denshiruko/cansat2026-board/cansat2026/cansat2026.kicad_pcb

## KiCad design cansat2026/cansat2026.kicad_pcb (2026-10-26)

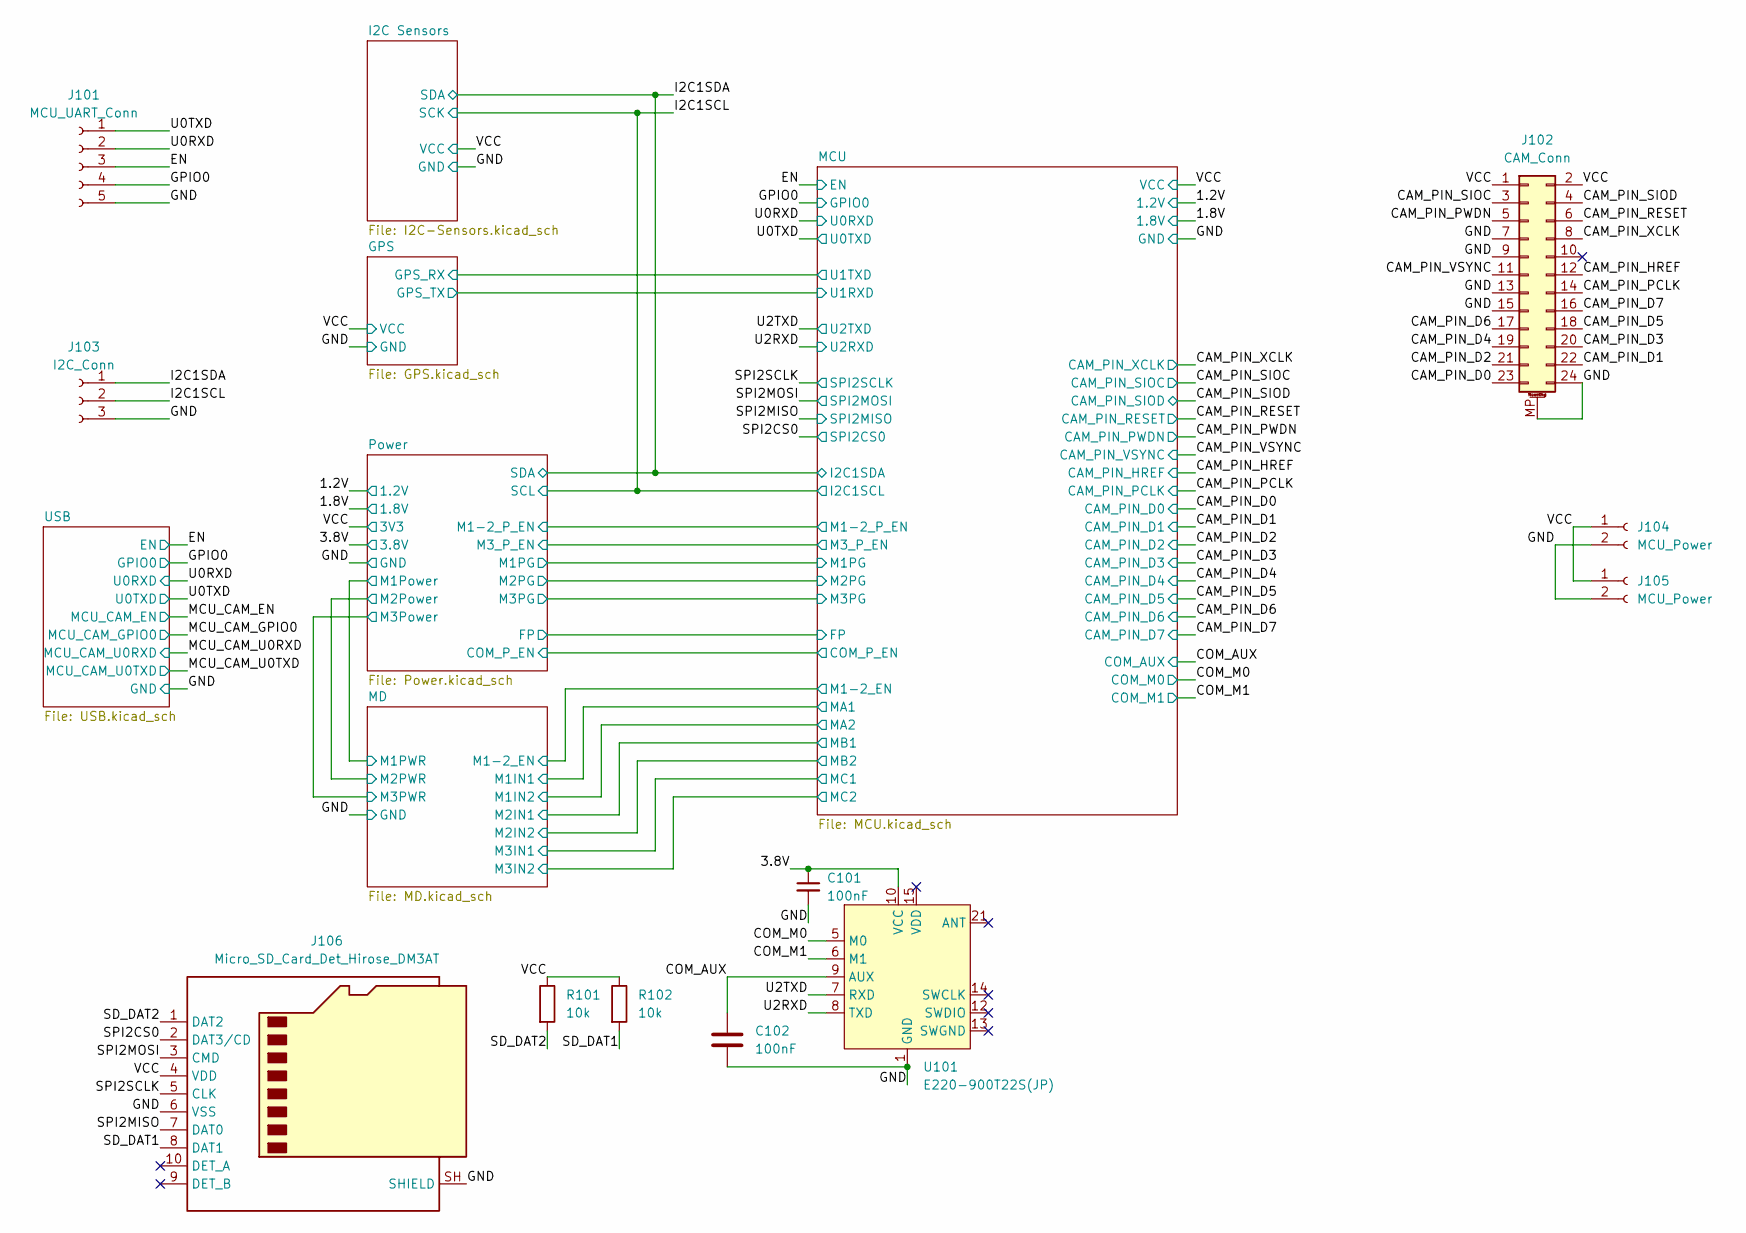
[picture p1: schematic cansat2026.kicad_sch]

Parts:
C101, C102: 100nF; C_0402_1005Metric; LCSC Part C1525
J101: MCU_UART_Conn; PinSocket_1x05_P2.54mm_Vertical
J102: CAM_Conn; SHOUHAN_XJH2.0_0.43-24P_1x24-1MP_P0.50mm_Horizontal; LCSC Part C5373439
J103: I2C_Conn; JST_XH_B3B-XH-A_1x03_P2.50mm_Vertical
J104, J105: MCU_Power; JST_XH_B2B-XH-A_1x02_P2.50mm_Vertical
J106: Micro_SD_Card_Det_Hirose_DM3AT; microSD_HC_Hirose_DM3AT-SF-PEJM5
R101, R102: 10k; R_0402_1005Metric; LCSC Part C25744
U101: E220-900T22S(JP)

Connections:
/3.8V: C101.1, U101.10 (VCC); also elsewhere on the board
/CAM_PIN_D0: J102.23; also elsewhere on the board
/CAM_PIN_D1: J102.22; also elsewhere on the board
/CAM_PIN_D2: J102.21; also elsewhere on the board
/CAM_PIN_D3: J102.20; also elsewhere on the board
/CAM_PIN_D4: J102.19; also elsewhere on the board
/CAM_PIN_D5: J102.18; also elsewhere on the board
/CAM_PIN_D6: J102.17; also elsewhere on the board
/CAM_PIN_D7: J102.16; also elsewhere on the board
/CAM_PIN_HREF: J102.12; also elsewhere on the board
/CAM_PIN_PCLK: J102.14; also elsewhere on the board
/CAM_PIN_PWDN: J102.5; also elsewhere on the board
/CAM_PIN_RESET: J102.6; also elsewhere on the board
/CAM_PIN_SIOC: J102.3; also elsewhere on the board
/CAM_PIN_SIOD: J102.4; also elsewhere on the board
/CAM_PIN_VSYNC: J102.11; also elsewhere on the board
/CAM_PIN_XCLK: J102.8; also elsewhere on the board
/COM_AUX: C102.1, U101.9 (AUX); also elsewhere on the board
/COM_M0: U101.5 (M0); also elsewhere on the board
/COM_M1: U101.6 (M1); also elsewhere on the board
/EN: J101.3; also elsewhere on the board
/GPIO0: J101.4; also elsewhere on the board
/I2C1SCL: J103.2; also elsewhere on the board
/I2C1SDA: J103.1; also elsewhere on the board
/SD_DAT1: J106.8 (DAT1), R102.2
/SD_DAT2: J106.1 (DAT2), R101.2
/SPI2CS0: J106.2 (DAT3/CD); also elsewhere on the board
/SPI2MISO: J106.7 (DAT0); also elsewhere on the board
/SPI2MOSI: J106.3 (CMD); also elsewhere on the board
/SPI2SCLK: J106.5 (CLK); also elsewhere on the board
/U0RXD: J101.2; also elsewhere on the board
/U0TXD: J101.1; also elsewhere on the board
/U2RXD: U101.8 (TXD); also elsewhere on the board
/U2TXD: U101.7 (RXD); also elsewhere on the board
/VCC: J102.1, J102.2, J104.1, J105.1, J106.4 (VDD), R101.1, R102.1; also elsewhere on the board
GND: C101.2, C102.2, J101.5, J102.7, J102.9, J102.13, J102.15, J102.24, J102.MP (MountPin), J103.3, J104.2, J105.2, J106.6 (VSS), J106.SH (SHIELD), U101.1 (GND), U101.2 (GND), U101.3 (GND), U101.4 (GND), U101.11 (GND), U101.19 (GND), U101.20 (GND), U101.22 (GND); also elsewhere on the board

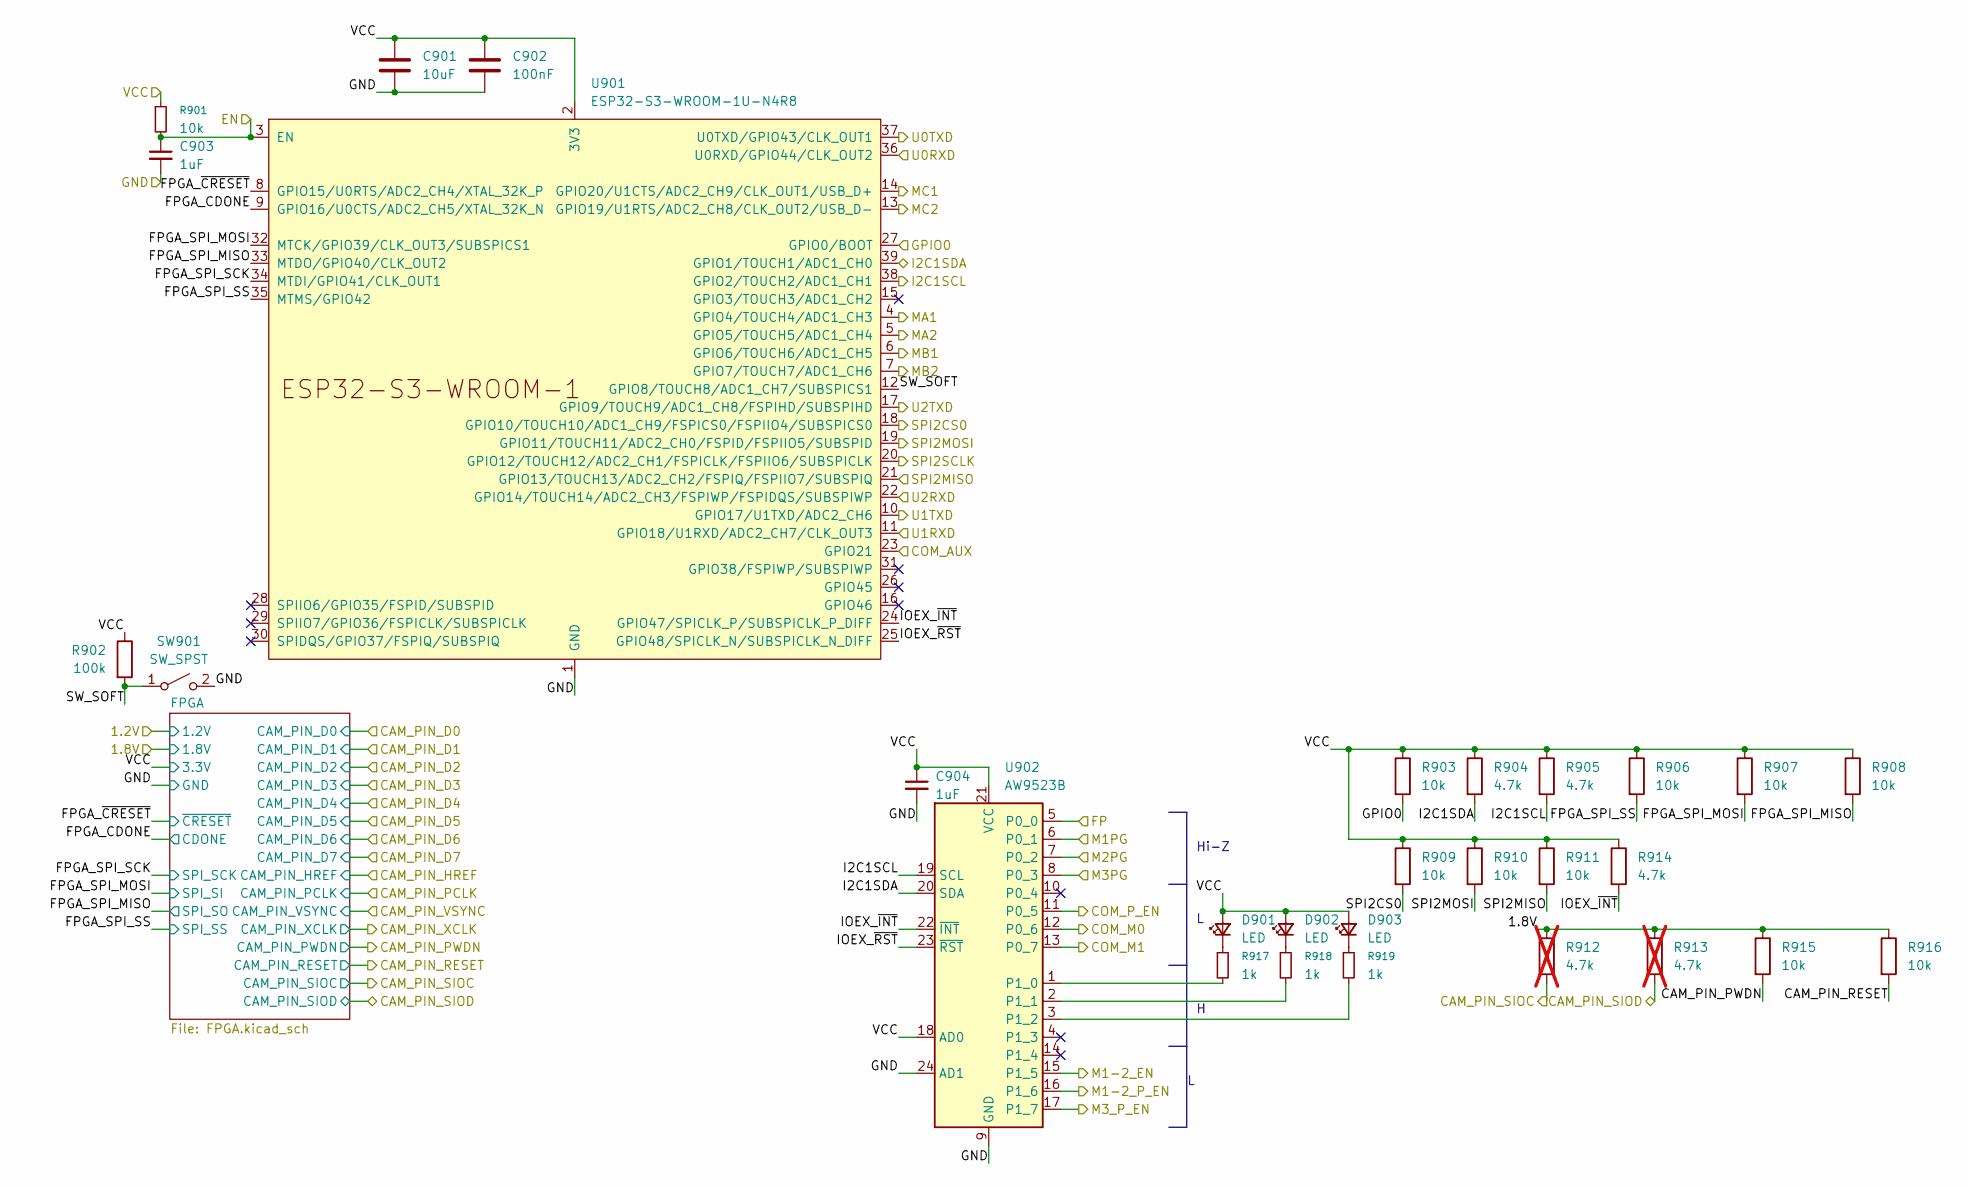
[picture p2: schematic MCU.kicad_sch]

Parts:
C901: 10uF; C_0402_1005Metric; LCSC Part C15525
C902: 100nF; C_0402_1005Metric; LCSC Part C1525
C903, C904: 1uF; C_0402_1005Metric; LCSC Part C52923
D901, D902, D903: LED; LED_0603_1608Metric
R901, R903, R906, R907, R908, R909, R910, R911, R915, R916: 10k; R_0402_1005Metric; LCSC Part C25744
R902: 100k; R_0402_1005Metric; LCSC Part C25741
R904, R905, R914: 4.7k; R_0402_1005Metric; LCSC Part C25900
R912, R913: 4.7k; R_0402_1005Metric; LCSC Part C25900; not fitted
R917, R918, R919: 1k; R_0402_1005Metric; LCSC Part C11702
SW901: SW_SPST; IS-1235-G
U901: ESP32-S3-WROOM-1U-N4R8; ESP32-S3-WROOM-1U; Mouser Part 356-ESP32S3WRM1UN4R8
U902: AW9523B; QFN-24-1EP_4x4mm_P0.5mm_EP2.7x2.7mm; LCSC Part C148077

Connections:
/1.8V: R912.1, R913.1, R915.1, R916.1; also elsewhere on the board
/CAM_PIN_PWDN: R915.2; also elsewhere on the board
/CAM_PIN_RESET: R916.2; also elsewhere on the board
/CAM_PIN_SIOC: R912.2; also elsewhere on the board
/CAM_PIN_SIOD: R913.2; also elsewhere on the board
/COM_AUX: U901.23 (GPIO21); also elsewhere on the board
/COM_M0: U902.12 (P0_6); also elsewhere on the board
/COM_M1: U902.13 (P0_7); also elsewhere on the board
/EN: C903.1, R901.2, U901.3 (EN); also elsewhere on the board
/GPIO0: R903.2, U901.27 (GPIO0/BOOT); also elsewhere on the board
/GPS/GPS_RX: U901.10 (GPIO17/U1TXD/ADC2_CH6); also elsewhere on the board
/GPS/GPS_TX: U901.11 (GPIO18/U1RXD/ADC2_CH7/CLK_OUT3); also elsewhere on the board
/I2C1SCL: R905.2, U901.38 (GPIO2/TOUCH2/ADC1_CH1), U902.19 (SCL); also elsewhere on the board
/I2C1SDA: R904.2, U901.39 (GPIO1/TOUCH1/ADC1_CH0), U902.20 (SDA); also elsewhere on the board
/MCU/COM_P_EN: U902.11 (P0_5); also elsewhere on the board
/MCU/FP: U902.5 (P0_0); also elsewhere on the board
/MCU/FPGA_CDONE: U901.9 (GPIO16/U0CTS/ADC2_CH5/XTAL_32K_N); also elsewhere on the board
/MCU/FPGA_SPI_MISO: R908.2, U901.33 (MTDO/GPIO40/CLK_OUT2); also elsewhere on the board
/MCU/FPGA_SPI_MOSI: R907.2, U901.32 (MTCK/GPIO39/CLK_OUT3/SUBSPICS1); also elsewhere on the board
/MCU/FPGA_SPI_SCK: U901.34 (MTDI/GPIO41/CLK_OUT1); also elsewhere on the board
/MCU/FPGA_SPI_SS: R906.2, U901.35 (MTMS/GPIO42); also elsewhere on the board
/MCU/FPGA_~CRESET: U901.8 (GPIO15/U0RTS/ADC2_CH4/XTAL_32K_P); also elsewhere on the board
/MCU/IOEX_~INT: R914.2, U901.24 (GPIO47/SPICLK_P/SUBSPICLK_P_DIFF), U902.22 (~INT)
/MCU/IOEX_~RST: U901.25 (GPIO48/SPICLK_N/SUBSPICLK_N_DIFF), U902.23 (~RST)
/MCU/M1-2_P_EN: U902.16 (P1_6); also elsewhere on the board
/MCU/M3_P_EN: U902.17 (P1_7); also elsewhere on the board
/MCU/MA1: U901.4 (GPIO4/TOUCH4/ADC1_CH3); also elsewhere on the board
/MCU/MA2: U901.5 (GPIO5/TOUCH5/ADC1_CH4); also elsewhere on the board
/MCU/MB1: U901.6 (GPIO6/TOUCH6/ADC1_CH5); also elsewhere on the board
/MCU/MB2: U901.7 (GPIO7/TOUCH7/ADC1_CH6); also elsewhere on the board
/MCU/MC1: U901.14 (GPIO20/U1CTS/ADC2_CH9/CLK_OUT1/USB_D+); also elsewhere on the board
/MCU/MC2: U901.13 (GPIO19/U1RTS/ADC2_CH8/CLK_OUT2/USB_D-); also elsewhere on the board
/MCU/SW_SOFT: R902.2, SW901.1 (A), U901.12 (GPIO8/TOUCH8/ADC1_CH7/SUBSPICS1)
/MD/M1-2_EN: U902.15 (P1_5); also elsewhere on the board
/Power/M1PG: U902.6 (P0_1); also elsewhere on the board
/Power/M2PG: U902.7 (P0_2); also elsewhere on the board
/Power/M3PG: U902.8 (P0_3); also elsewhere on the board
/SPI2CS0: R909.2, U901.18 (GPIO10/TOUCH10/ADC1_CH9/FSPICS0/FSPIIO4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); also elsewhere on the board
/SPI2MISO: R911.2, U901.21 (GPIO13/TOUCH13/ADC2_CH2/FSPIQ/FSPIIO7/S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); also elsewhere on the board
/SPI2MOSI: R910.2, U901.19 (GPIO11/TOUCH11/ADC2_CH0/FSPID/FSPIIO5/S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); also elsewhere on the board
/SPI2SCLK: U901.20 (GPIO12/TOUCH12/ADC2_CH1/FSPICLK/FSPIIO6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); also elsewhere on the board
/U0RXD: U901.36 (U0RXD/GPIO44/CLK_OUT2); also elsewhere on the board
/U0TXD: U901.37 (U0TXD/GPIO43/CLK_OUT1); also elsewhere on the board
/U2RXD: U901.22 (GPIO14/TOUCH14/ADC2_CH3/FSPIWP/FSPIDQS/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); also elsewhere on the board
/U2TXD: U901.17 (GPIO9/TOUCH9/ADC1_CH8/FSPIHD/SUBSPIHD); also elsewhere on the board
/VCC: C901.1, C902.1, C904.1, D901.2 (A), D902.2 (A), D903.2 (A), R901.1, R902.1, R903.1, R904.1, R905.1, R906.1, R907.1, R908.1, R909.1, R910.1, R911.1, R914.1, U901.2 (3V3), U902.18 (AD0), U902.21 (VCC); also elsewhere on the board
GND: C901.2, C902.2, C903.2, C904.2, SW901.2 (B), U901.1 (GND), U901.40 (GND), U901.41 (GND), U902.9 (GND), U902.24 (AD1), U902.25 (GND); also elsewhere on the board
unnamed: D901.1 (K), R917.1
unnamed: D902.1 (K), R918.1
unnamed: D903.1 (K), R919.1
unnamed: R917.2, U902.1 (P1_0)
unnamed: R918.2, U902.2 (P1_1)
unnamed: R919.2, U902.3 (P1_2)

Notes on the sheet:
Hi-Z

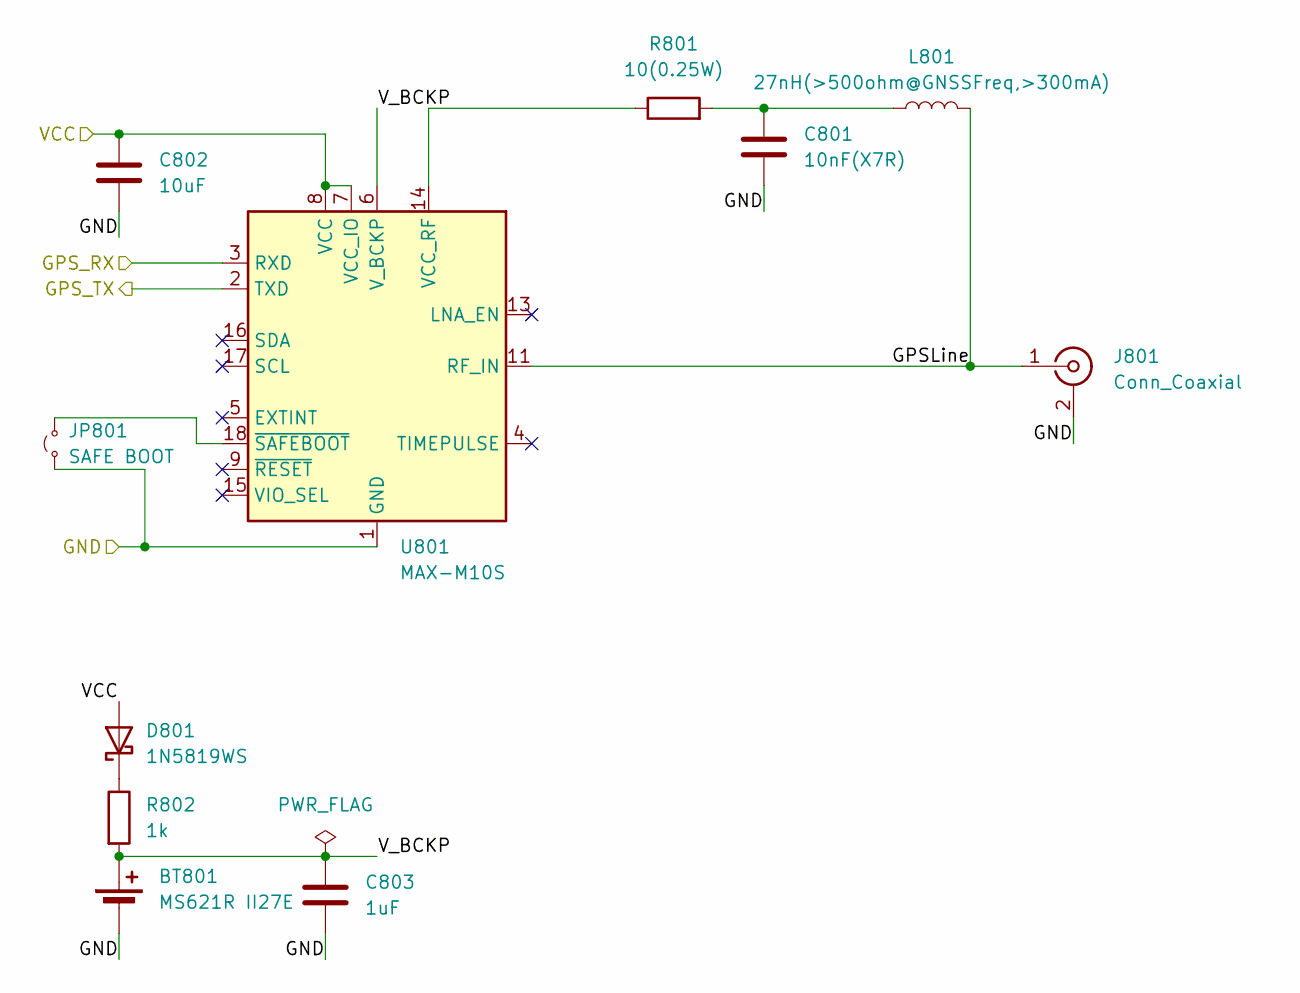
[picture p3: schematic GPS.kicad_sch]

Parts:
BT801: MS621R II27E; BAT_MS621R-II27E
C801: 10nF(X7R); C_0402_1005Metric; LCSC Part C15195
C802: 10uF; C_0402_1005Metric; LCSC Part C15525
C803: 1uF; C_0402_1005Metric; LCSC Part C52923
D801: 1N5819WS; D_SOD-323; LCSC Part C191023
J801: Conn_Coaxial; U.FL_Hirose_U.FL-R-SMT-1_Vertical
JP801: SAFE BOOT; SolderJumper-2_P1.3mm_Open_RoundedPad1.0x1.5mm
L801: 27nH(>500ohm@GNSSFreq,>300mA); L_0603_1608Metric; LCSC Part C148128
R801: 10(0.25W); R_1206_3216Metric; LCSC Part C17903
R802: 1k; R_0402_1005Metric; LCSC Part C11702
U801: MAX-M10S; ublox_MAX; DigiKey Part MAX-M10S-00B

Connections:
/GPS/GPSLine: J801.1 (In), L801.2, U801.11 (RF_IN)
/GPS/GPS_RX: U801.3 (RXD); also elsewhere on the board
/GPS/GPS_TX: U801.2 (TXD); also elsewhere on the board
/GPS/V_BCKP: BT801.1 (+), C803.1, R802.2, U801.6 (V_BCKP)
/VCC: C802.1, D801.2 (A), U801.7 (VCC_IO), U801.8 (VCC); also elsewhere on the board
GND: BT801.2 (-), C801.2, C802.2, C803.2, J801.2 (Ext), JP801.1 (A), U801.1 (GND), U801.10 (GND), U801.12 (GND); also elsewhere on the board
unnamed: C801.1, L801.1, R801.2
unnamed: D801.1 (K), R802.1
unnamed: JP801.2 (B), U801.18 (~SAFEBOOT)
unnamed: R801.1, U801.14 (VCC_RF)

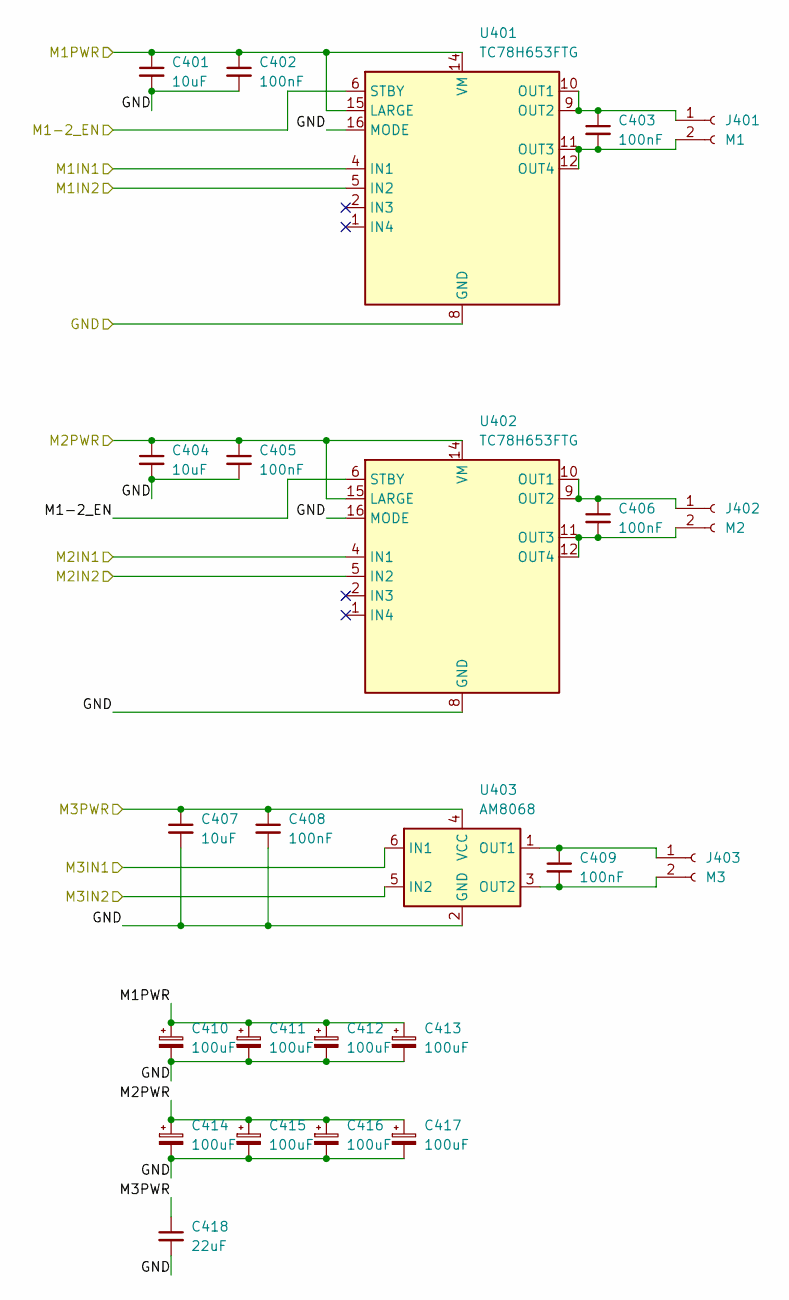
[picture p4: schematic MD.kicad_sch]

Parts:
C401, C404, C407: 10uF; C_0603_1608Metric; LCSC Part C19702
C402, C403, C405, C406, C408, C409: 100nF; C_0402_1005Metric; LCSC Part C1525
C410, C411, C412, C413, C414, C415, C416, C417: 100uF; MURATA_ECAS_D6
C418: 22uF; C_0805_2012Metric; LCSC Part C45783
J401: M1; JST_VH_B2P-VH_1x02_P3.96mm_Vertical
J402: M2; JST_VH_B2P-VH_1x02_P3.96mm_Vertical
J403: M3; JST_XH_B2B-XH-A_1x02_P2.50mm_Vertical
U401, U402: TC78H653FTG; VQFN-16-1EP_3x3mm_P0.5mm_EP1.8x1.8mm; LCSC Part C2150463
U403: AM8068; SOT-23-6

Connections:
/MCU/MA1: U401.4 (IN1); also elsewhere on the board
/MCU/MA2: U401.5 (IN2); also elsewhere on the board
/MCU/MB1: U402.4 (IN1); also elsewhere on the board
/MCU/MB2: U402.5 (IN2); also elsewhere on the board
/MCU/MC1: U403.6 (IN1); also elsewhere on the board
/MCU/MC2: U403.5 (IN2); also elsewhere on the board
/MD/M1-2_EN: U401.6 (STBY), U402.6 (STBY); also elsewhere on the board
/MD/M1PWR: C401.1, C402.1, C410.1, C411.1, C412.1, C413.1, U401.14 (VM), U401.15 (LARGE); also elsewhere on the board
/MD/M2PWR: C404.1, C405.1, C414.1, C415.1, C416.1, C417.1, U402.14 (VM), U402.15 (LARGE); also elsewhere on the board
/MD/M3PWR: C407.1, C408.1, C418.1, U403.4 (VCC); also elsewhere on the board
GND: C401.2, C402.2, C404.2, C405.2, C407.2, C408.2, C410.2, C411.2, C412.2, C413.2, C414.2, C415.2, C416.2, C417.2, C418.2, U401.8 (GND), U401.13 (GND), U401.16 (MODE), U401.17 (GND), U402.8 (GND), U402.13 (GND), U402.16 (MODE), U402.17 (GND), U403.2 (GND); also elsewhere on the board
unnamed: C403.1, J401.1, U401.9 (OUT2), U401.10 (OUT1)
unnamed: C403.2, J401.2, U401.11 (OUT3), U401.12 (OUT4)
unnamed: C406.1, J402.1, U402.9 (OUT2), U402.10 (OUT1)
unnamed: C406.2, J402.2, U402.11 (OUT3), U402.12 (OUT4)
unnamed: C409.1, J403.1, U403.1 (OUT1)
unnamed: C409.2, J403.2, U403.3 (OUT2)

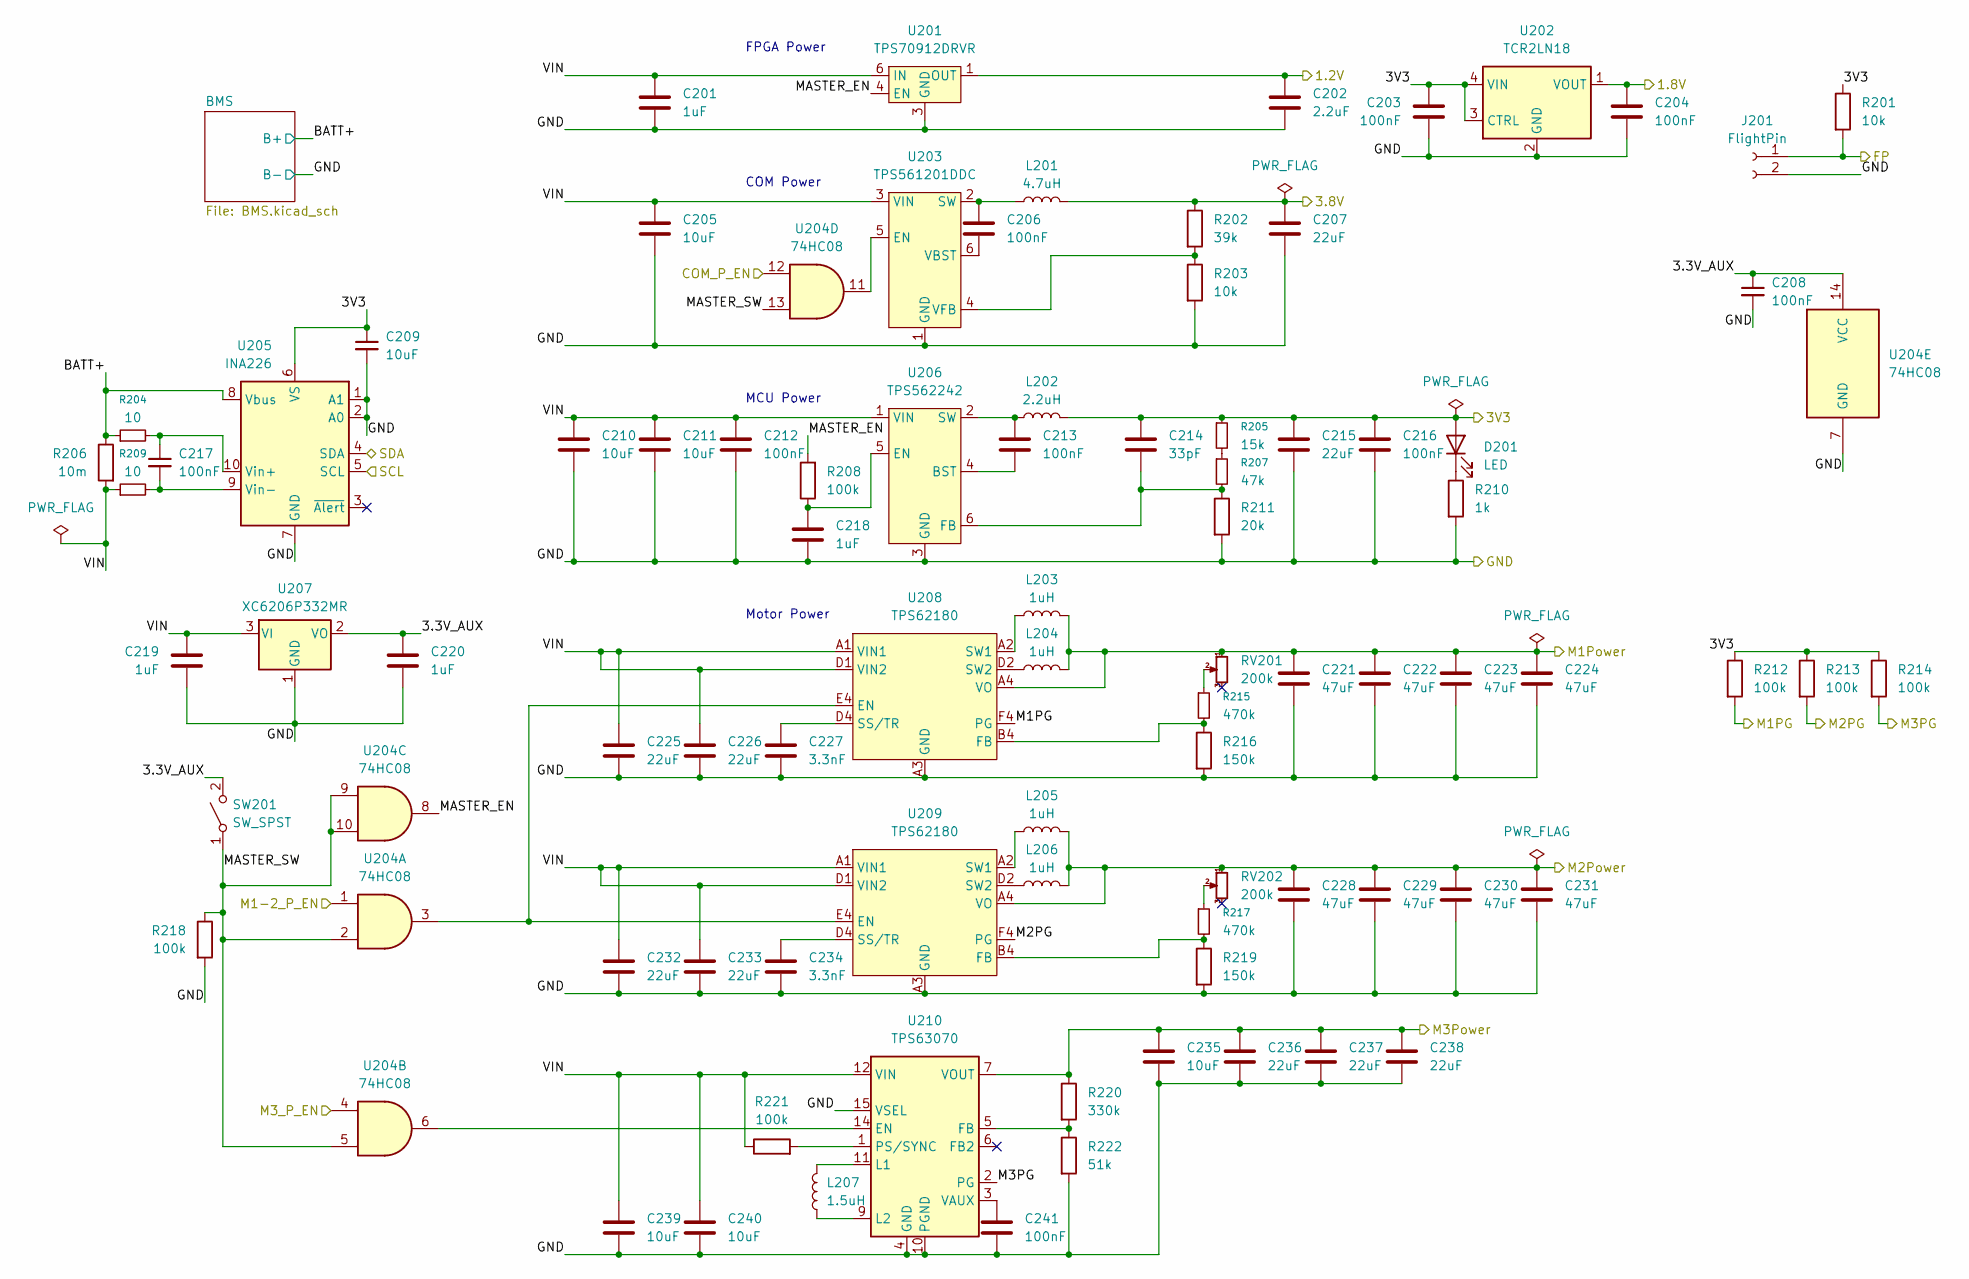
[picture p5: schematic Power.kicad_sch]

Parts:
C201, C218, C219, C220: 1uF; C_0402_1005Metric; LCSC Part C52923
C202: 2.2uF; C_0402_1005Metric; LCSC Part C12530
C203, C204, C206, C208, C212, C213, C216, C217, C241: 100nF; C_0402_1005Metric; LCSC Part C1525
C205, C210, C211, C235, C239, C240: 10uF; C_0805_2012Metric; LCSC Part C15850
C207, C215, C225, C226, C232, C233, C236, C237, C238: 22uF; C_0805_2012Metric; LCSC Part C45783
C209: 10uF; C_0402_1005Metric; LCSC Part C15525
C214: 33pF; C_0402_1005Metric; LCSC Part C1562
C221, C222, C223, C224, C228, C229, C230, C231: 47uF; C_0805_2012Metric; LCSC Part C16780
C227, C234: 3.3nF; C_0603_1608Metric; LCSC Part C1613
D201: LED; LED_0603_1608Metric
J201: FlightPin; JST_XH_B2B-XH-A_1x02_P2.50mm_Vertical
L201: 4.7uH; L_1008_2520Metric_Pad1.43x2.20mm_HandSolder; DigiKey Part WIP252012S-4R7MLDG
L202: 2.2uH; L_Taiyo-Yuden_NR-50xx_HandSoldering; Mouser Part 963-LSXND5050WDL2R2N
L203, L204, L205, L206: 1uH; L_Taiyo-Yuden_LSEU-4040; Mouser Part 963-LSEUB4040WKT1R0M
L207: 1.5uH; L_Wuerth_PMCI-201610; DigiKey Part WIP201610S-1R5MLDG
R201, R203: 10k; R_0402_1005Metric; LCSC Part C25744
R202: 39k; R_0402_1005Metric; LCSC Part C25783
R204, R209: 10; R_0402_1005Metric; LCSC Part C25077
R205: 15k; R_0402_1005Metric; LCSC Part C25756
R206: 10m; R_1206_3216Metric; LCSC Part C20160275
R207: 47k; R_0402_1005Metric; LCSC Part C25792
R208, R212, R213, R214, R218, R221: 100k; R_0402_1005Metric; LCSC Part C25741
R210: 1k; R_0402_1005Metric; LCSC Part C11702
R211: 20k; R_0402_1005Metric; LCSC Part C25765
R215, R217: 470k; R_0402_1005Metric; LCSC Part C25790
R216, R219: 150k; R_0402_1005Metric; LCSC Part C25755
R220: 330k; R_0402_1005Metric; LCSC Part C25778
R222: 51k; R_0402_1005Metric; LCSC Part C25794
RV201, RV202: 200k; Potentiometer_Bourns_TC33X_Vertical; DigiKey Part TC33X-2-204E
SW201: SW_SPST; SW_DIP_SPSTx01_Slide_6.7x4.1mm_W8.61mm_P2.54mm_LowProfile; DigiKey Part DS04-254-1-01BK-SMT
U201: TPS70912DRVR; WSON-6-1EP_2x2mm_P0.65mm_EP1x1.6mm; LCSC Part C2863472
U202: TCR2LN18; SDFN4; LCSC Part C7360727
U203: TPS561201DDC; SOT-23-6; LCSC Part C220433
U204: 74HC08; SOIC-14_3.9x8.7mm_P1.27mm; LCSC Part C5593
U205: INA226; TSSOP-10_3x3mm_P0.5mm; LCSC Part C49851
U206: TPS562242; SOT-563; LCSC Part C19272253
U207: XC6206P332MR; SOT-23-3; LCSC Part C5446
U208, U209: TPS62180; TPS62180YZF; LCSC Part C2071394
U210: TPS63070; QFN-16_2.4x2.9_Pitch0.5mm; LCSC Part C2072046

Connections:
/1.2V: C202.1, U201.1 (OUT); also elsewhere on the board
/1.8V: C204.1, U202.1 (VOUT); also elsewhere on the board
/3.8V: C207.1, L201.2, R202.1; also elsewhere on the board
/I2C1SCL: U205.5 (SCL); also elsewhere on the board
/I2C1SDA: U205.4 (SDA); also elsewhere on the board
/MCU/COM_P_EN: U204.12; also elsewhere on the board
/MCU/FP: J201.1, R201.2; also elsewhere on the board
/MCU/M1-2_P_EN: U204.1; also elsewhere on the board
/MCU/M3_P_EN: U204.4; also elsewhere on the board
/MD/M1PWR: C221.1, C222.1, C223.1, C224.1, L203.2, L204.2, RV201.1, U208.A4 (VO); also elsewhere on the board
/MD/M2PWR: C228.1, C229.1, C230.1, C231.1, L205.2, L206.2, RV202.1, U209.A4 (VO); also elsewhere on the board
/MD/M3PWR: C235.1, C236.1, C237.1, C238.1, R220.1, U210.7 (VOUT), U210.8 (VOUT); also elsewhere on the board
/Power/3.3V_AUX: C208.1, C220.1, SW201.2 (B), U204.14 (VCC), U207.2 (VO)
/Power/BATT+: R204.1, R206.1, U205.8 (Vbus); also elsewhere on the board
/Power/M1PG: R212.2, U208.F4 (PG); also elsewhere on the board
/Power/M2PG: R213.2, U209.F4 (PG); also elsewhere on the board
/Power/M3PG: R214.2, U210.2 (PG); also elsewhere on the board
/Power/MASTER_EN: R208.2, U201.4 (EN), U204.8
/Power/MASTER_SW: R218.1, SW201.1 (A), U204.2, U204.5, U204.9, U204.10, U204.13
/VCC: C203.1, C209.1, C214.1, C215.1, C216.1, D201.2 (A), L202.2, R201.1, R205.1, R212.1, R213.1, R214.1, U202.3 (CTRL), U202.4 (VIN), U205.6 (VS); also elsewhere on the board
GND: C201.2, C202.2, C203.2, C204.2, C205.2, C207.2, C208.2, C209.2, C210.2, C211.2, C212.2, C215.2, C216.2, C218.2, C219.2, C220.2, C221.2, C222.2, C223.2, C224.2, C225.2, C226.2, C227.2, C228.2, C229.2, C230.2, C231.2, C232.2, C233.2, C234.2, C235.2, C236.2, C237.2, C238.2, C239.2, C240.2, C241.2, J201.2, R203.2, R210.2, R211.2, R216.2, R218.2, R219.2, R222.2, U201.3 (GND), U201.7 (GND), U202.2 (GND), U203.1 (GND), U204.7 (GND), U205.1 (A1), U205.2 (A0), U205.7 (GND), U206.3 (GND), U207.1 (GND), U208.A3 (GND), U208.B3 (GND), U208.C3 (GND), U208.C4 (GND), U208.D3 (GND), U208.E3 (GND), U208.F3 (GND), U209.A3 (GND), U209.B3 (GND), U209.C3 (GND), U209.C4 (GND), U209.D3 (GND), U209.E3 (GND), U209.F3 (GND), U210.4 (GND), U210.10 (PGND), U210.15 (VSEL); also elsewhere on the board
unnamed: D201.1 (K), R210.1
unnamed: L203.1, U208.A2 (SW1), U208.B2 (SW1), U208.C2 (SW1)
unnamed: L204.1, U208.D2 (SW2), U208.E2 (SW2), U208.F2 (SW2)
unnamed: L205.1, U209.A2 (SW1), U209.B2 (SW1), U209.C2 (SW1)
unnamed: L206.1, U209.D2 (SW2), U209.E2 (SW2), U209.F2 (SW2)
unnamed: R205.2, R207.1
unnamed: R215.1, RV201.2
unnamed: R217.1, RV202.2
unnamed: U203.5 (EN), U204.11
unnamed: C206.1, L201.1, U203.2 (SW)
unnamed: C206.2, U203.6 (VBST)
unnamed: R202.2, R203.1, U203.4 (VFB)
unnamed: C217.1, R204.2, U205.10 (Vin+)
unnamed: C217.2, R209.2, U205.9 (Vin-)
unnamed: C213.2, U206.4 (BST)
unnamed: C218.1, R208.1, U206.5 (EN)
unnamed: C214.2, R207.2, R211.1, U206.6 (FB)
unnamed: C213.1, L202.1, U206.2 (SW)
unnamed: U204.3, U208.E4 (EN), U209.E4 (EN)
unnamed: R215.2, R216.1, U208.B4 (FB)
unnamed: C227.1, U208.D4 (SS/TR)
unnamed: R217.2, R219.1, U209.B4 (FB)
unnamed: C234.1, U209.D4 (SS/TR)
unnamed: U204.6, U210.14 (EN)
unnamed: R220.2, R222.1, U210.5 (FB)
unnamed: L207.2, U210.11 (L1)
unnamed: L207.1, U210.9 (L2)
unnamed: R221.2, U210.1 (PS/SYNC)
unnamed: C241.1, U210.3 (VAUX)
VIN: C201.1, C205.1, C210.1, C211.1, C212.1, C219.1, C225.1, C226.1, C232.1, C233.1, C239.1, C240.1, R206.2, R209.1, R221.1, U201.6 (IN), U203.3 (VIN), U206.1 (VIN), U207.3 (VI), U208.A1 (VIN1), U208.B1 (VIN1), U208.C1 (VIN1), U208.D1 (VIN2), U208.E1 (VIN2), U208.F1 (VIN2), U209.A1 (VIN1), U209.B1 (VIN1), U209.C1 (VIN1), U209.D1 (VIN2), U209.E1 (VIN2), U209.F1 (VIN2), U210.12 (VIN), U210.13 (VIN)

Notes on the sheet:
COM Power
FPGA Power
MCU Power
Motor Power

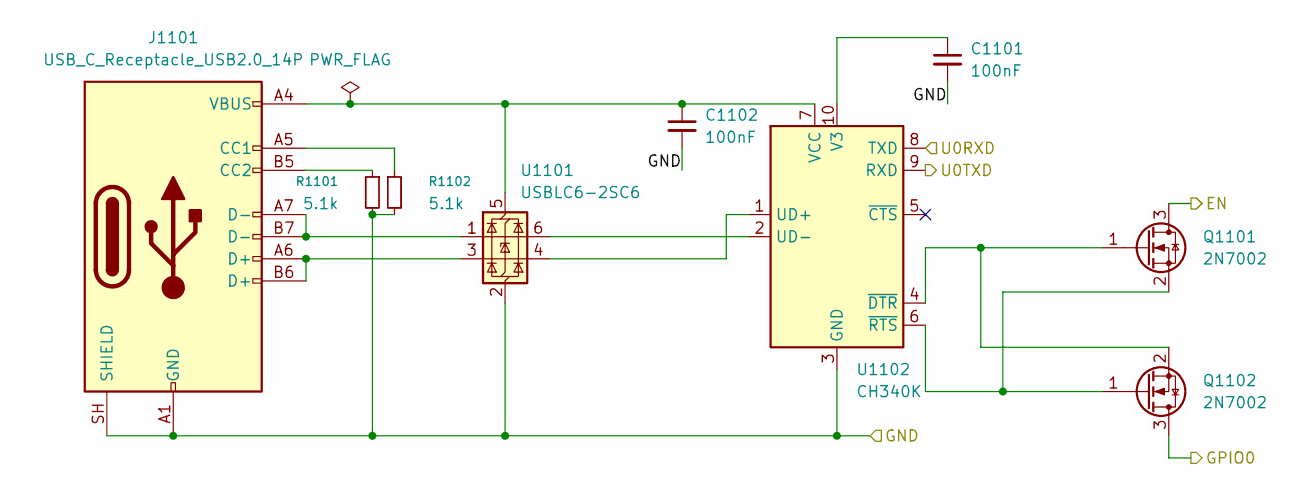
[picture p6: schematic USB.kicad_sch]

Parts:
C1101, C1102: 100nF; C_0402_1005Metric; LCSC Part C1525
J1101: USB_C_Receptacle_USB2.0_14P; USB_C_Receptacle_GCT_USB4105-xx-A_16P_TopMnt_Horizontal; LCSC Part C36936538
Q1101, Q1102: 2N7002; SOT-23; LCSC Part C8545
R1101, R1102: 5.1k; R_0402_1005Metric; LCSC Part C25905
U1101: USBLC6-2SC6; SOT-23-6; LCSC Part C5180249
U1102: CH340K; SSOP-10-1EP_3.9x4.9mm_P1mm_EP2.1x3.3mm

Connections:
/EN: Q1101.3 (D); also elsewhere on the board
/GPIO0: Q1102.3 (D); also elsewhere on the board
/U0RXD: U1102.8 (TXD); also elsewhere on the board
/U0TXD: U1102.9 (RXD); also elsewhere on the board
GND: C1101.2, C1102.2, J1101.A1 (GND), J1101.A12 (GND), J1101.B1 (GND), J1101.B12 (GND), J1101.SH (SHIELD), R1101.2, R1102.2, U1101.2 (GND), U1102.3 (GND), U1102.11 (GND); also elsewhere on the board
unnamed: J1101.A5 (CC1), R1102.1
unnamed: J1101.B5 (CC2), R1101.1
unnamed: J1101.A6 (D+), J1101.B6 (D+), U1101.3 (I/O2)
unnamed: J1101.A7 (D-), J1101.B7 (D-), U1101.1 (I/O1)
unnamed: Q1101.1 (G), Q1102.2 (S), U1102.4 (~DTR)
unnamed: Q1101.2 (S), Q1102.1 (G), U1102.6 (~RTS)
unnamed: C1102.1, J1101.A4 (VBUS), J1101.A9 (VBUS), J1101.B4 (VBUS), J1101.B9 (VBUS), U1101.5 (VBUS), U1102.7 (VCC)
unnamed: U1101.4 (I/O2), U1102.1 (UD+)
unnamed: U1101.6 (I/O1), U1102.2 (UD-)
unnamed: C1101.1, U1102.10 (V3)
