denshiruko/cansat2026-board/cansat2026/cansat2026.kicad_pcb

## KiCad design cansat2026/cansat2026.kicad_pcb (continued)

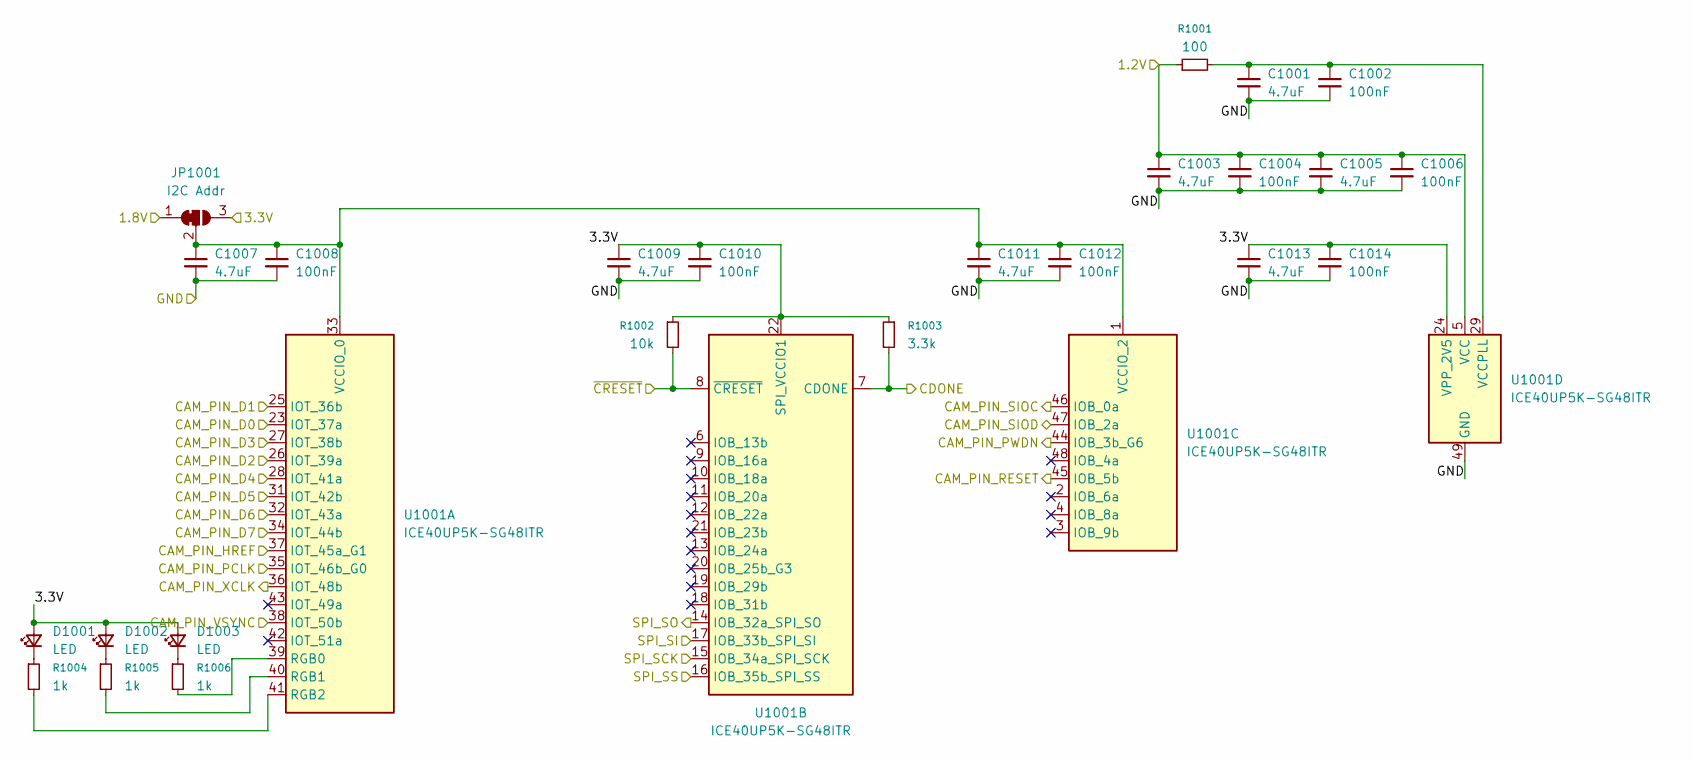
[picture p7: schematic FPGA.kicad_sch]

Parts:
C1001, C1003, C1005, C1007, C1009, C1011, C1013: 4.7uF; C_0402_1005Metric; LCSC Part C23733
C1002, C1004, C1006, C1008, C1010, C1012, C1014: 100nF; C_0402_1005Metric; LCSC Part C1525
D1001, D1002, D1003: LED; LED_0603_1608Metric
JP1001: I2C Addr; SolderJumper-3_P1.3mm_Bridged12_RoundedPad1.0x1.5mm_NumberL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
R1001: 100; R_0402_1005Metric; LCSC Part C25076
R1002: 10k; R_0402_1005Metric; LCSC Part C25744
R1003: 3.3k; R_0402_1005Metric; LCSC Part C25890
R1004, R1005, R1006: 1k; R_0402_1005Metric; LCSC Part C11702
U1001: ICE40UP5K-SG48ITR; QFN-48-1EP_7x7mm_P0.5mm_EP5.6x5.6mm; LCSC Part C2678152

Connections:
/1.2V: C1003.1, C1004.1, C1005.1, C1006.1, R1001.1, U1001.5 (VCC), U1001.30 (VCC); also elsewhere on the board
/1.8V: JP1001.1 (A); also elsewhere on the board
/CAM_PIN_D0: U1001.23 (IOT_37a); also elsewhere on the board
/CAM_PIN_D1: U1001.25 (IOT_36b); also elsewhere on the board
/CAM_PIN_D2: U1001.26 (IOT_39a); also elsewhere on the board
/CAM_PIN_D3: U1001.27 (IOT_38b); also elsewhere on the board
/CAM_PIN_D4: U1001.28 (IOT_41a); also elsewhere on the board
/CAM_PIN_D5: U1001.31 (IOT_42b); also elsewhere on the board
/CAM_PIN_D6: U1001.32 (IOT_43a); also elsewhere on the board
/CAM_PIN_D7: U1001.34 (IOT_44b); also elsewhere on the board
/CAM_PIN_HREF: U1001.37 (IOT_45a_G1); also elsewhere on the board
/CAM_PIN_PCLK: U1001.35 (IOT_46b_G0); also elsewhere on the board
/CAM_PIN_PWDN: U1001.44 (IOB_3b_G6); also elsewhere on the board
/CAM_PIN_RESET: U1001.45 (IOB_5b); also elsewhere on the board
/CAM_PIN_SIOC: U1001.46 (IOB_0a); also elsewhere on the board
/CAM_PIN_SIOD: U1001.47 (IOB_2a); also elsewhere on the board
/CAM_PIN_VSYNC: U1001.38 (IOT_50b); also elsewhere on the board
/CAM_PIN_XCLK: U1001.36 (IOT_48b); also elsewhere on the board
/MCU/FPGA_CDONE: R1003.2, U1001.7 (CDONE); also elsewhere on the board
/MCU/FPGA_SPI_MISO: U1001.14 (IOB_32a_SPI_SO); also elsewhere on the board
/MCU/FPGA_SPI_MOSI: U1001.17 (IOB_33b_SPI_SI); also elsewhere on the board
/MCU/FPGA_SPI_SCK: U1001.15 (IOB_34a_SPI_SCK); also elsewhere on the board
/MCU/FPGA_SPI_SS: U1001.16 (IOB_35b_SPI_SS); also elsewhere on the board
/MCU/FPGA_~CRESET: R1002.2, U1001.8 (~CRESET); also elsewhere on the board
/VCC: C1009.1, C1010.1, C1013.1, C1014.1, D1001.2 (A), D1002.2 (A), D1003.2 (A), JP1001.3 (B), R1002.1, R1003.1, U1001.22 (SPI_VCCIO1), U1001.24 (VPP_2V5); also elsewhere on the board
GND: C1001.2, C1002.2, C1003.2, C1004.2, C1005.2, C1006.2, C1007.2, C1008.2, C1009.2, C1010.2, C1011.2, C1012.2, C1013.2, C1014.2, U1001.49 (GND); also elsewhere on the board
unnamed: D1001.1 (K), R1004.1
unnamed: D1002.1 (K), R1005.1
unnamed: D1003.1 (K), R1006.1
unnamed: C1007.1, C1008.1, C1011.1, C1012.1, JP1001.2 (C), U1001.1 (VCCIO_2), U1001.33 (VCCIO_0)
unnamed: R1006.2, U1001.39 (RGB0)
unnamed: R1005.2, U1001.40 (RGB1)
unnamed: R1004.2, U1001.41 (RGB2)
unnamed: C1001.1, C1002.1, R1001.2, U1001.29 (VCCPLL)

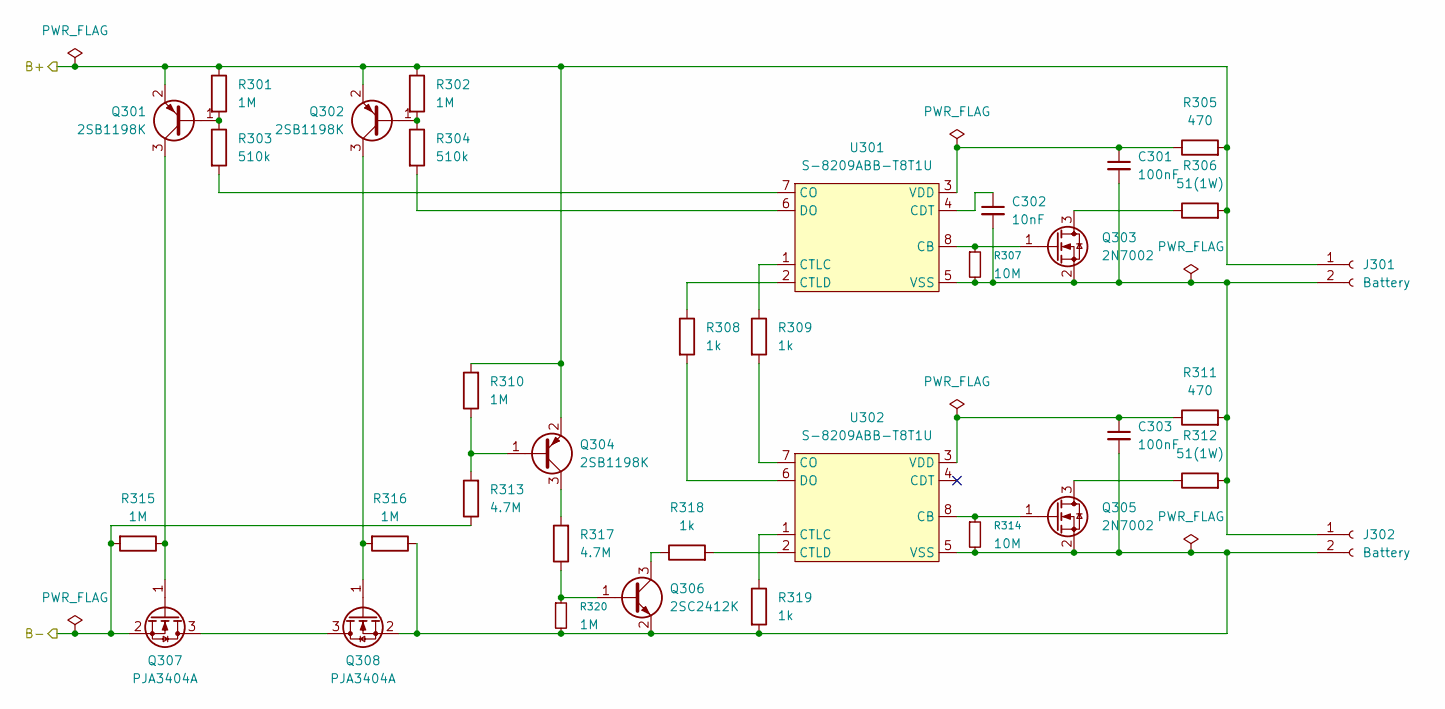
[picture p8: schematic BMS.kicad_sch]

Parts:
C301, C303: 100nF; C_0402_1005Metric; LCSC Part C1525
C302: 10nF; C_0402_1005Metric; LCSC Part C15195
J301, J302: Battery; JST_VH_B2P-VH_1x02_P3.96mm_Vertical
Q301, Q302, Q304: 2SB1198K; SC-59; LCSC Part C266246
Q303, Q305: 2N7002; SOT-23; LCSC Part C8545
Q306: 2SC2412K; SC-59; LCSC Part C111699
Q307, Q308: PJA3404A; SOT-23; Mouser Part 241-PJA3404AR100001
R301, R302, R310, R315, R316, R320: 1M; R_0402_1005Metric; LCSC Part C26083
R303, R304: 510k; R_0402_1005Metric; LCSC Part C11616
R305, R311: 470; R_0402_1005Metric; LCSC Part C25117
R306, R312: 51(1W); R_1206_3216Metric; Mouser Part 660-SG73S2BTTD51R0F
R307, R314: 10M; R_0603_1608Metric; LCSC Part C7250
R308, R309, R318, R319: 1k; R_0402_1005Metric; LCSC Part C11702
R313, R317: 4.7M; R_0603_1608Metric; LCSC Part C23163
U301, U302: S-8209ABB-T8T1U; TSSOP-8_4.4x3mm_P0.65mm; Mouser Part 628-S-8209ABB-T8T1U

Connections:
/Power/BATT+: J301.1, Q301.2, Q302.2, Q304.2, R301.1, R302.1, R305.2, R306.2, R310.2; also elsewhere on the board
GND: Q307.2 (S), R313.1, R315.2; also elsewhere on the board
unnamed: C301.2, C302.2, J301.2, J302.1, Q303.2 (S), R307.2, R311.2, R312.2, U301.5 (VSS)
unnamed: C303.2, J302.2, Q305.2 (S), Q306.2, Q308.2 (S), R314.2, R316.1, R319.2, R320.2, U302.5 (VSS)
unnamed: Q301.1, R301.2, R303.1
unnamed: Q302.1, R302.2, R304.1
unnamed: Q303.3 (D), R306.1
unnamed: Q303.1 (G), R307.1, U301.8 (CB)
unnamed: Q304.1, R310.1, R313.2
unnamed: Q304.3, R317.2
unnamed: Q305.3 (D), R312.1
unnamed: Q305.1 (G), R314.1, U302.8 (CB)
unnamed: Q306.1, R317.1, R320.1
unnamed: Q306.3, R318.1
unnamed: Q307.3 (D), Q308.3 (D)
unnamed: Q301.3, Q307.1 (G), R315.1
unnamed: Q302.3, Q308.1 (G), R316.2
unnamed: C302.1, U301.4 (CDT)
unnamed: R303.2, U301.7 (CO)
unnamed: R309.1, U301.1 (CTLC)
unnamed: R308.1, U301.2 (CTLD)
unnamed: R304.2, U301.6 (DO)
unnamed: C301.1, R305.1, U301.3 (VDD)
unnamed: R309.2, U302.7 (CO)
unnamed: R319.1, U302.1 (CTLC)
unnamed: R318.2, U302.2 (CTLD)
unnamed: R308.2, U302.6 (DO)
unnamed: C303.1, R311.1, U302.3 (VDD)

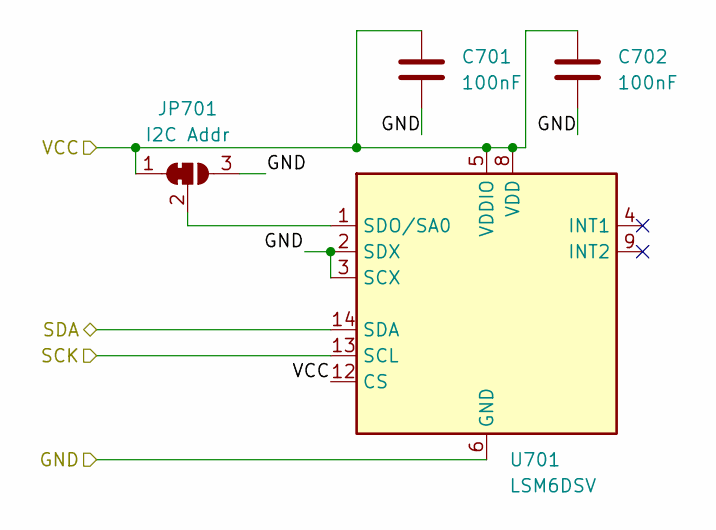
[picture p9: schematic IMU.kicad_sch]

Parts:
C701, C702: 100nF; C_0402_1005Metric; LCSC Part C1525
JP701: I2C Addr; SolderJumper-3_P1.3mm_Bridged12_RoundedPad1.0x1.5mm_NumberL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
U701: LSM6DSV; LGA-14_3x2.5mm_P0.5mm_LayoutBorder3x4y

Connections:
/I2C1SCL: U701.13 (SCL); also elsewhere on the board
/I2C1SDA: U701.14 (SDA); also elsewhere on the board
/VCC: C701.1, C702.1, JP701.1 (A), U701.5 (VDDIO), U701.8 (VDD), U701.12 (CS); also elsewhere on the board
GND: C701.2, C702.2, JP701.3 (B), U701.2 (SDX), U701.3 (SCX), U701.6 (GND), U701.7 (GND); also elsewhere on the board
unnamed: JP701.2 (C), U701.1 (SDO/SA0)

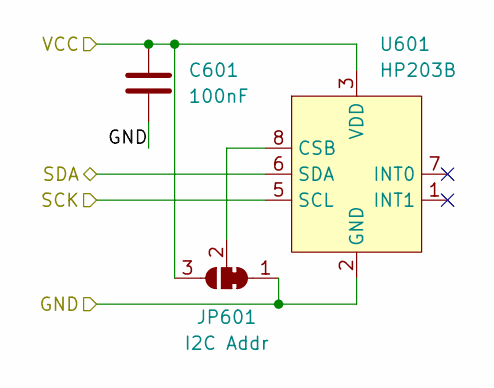
[picture p10: schematic PressureSensor.kicad_sch]

Parts:
C601: 100nF; C_0402_1005Metric; LCSC Part C1525
JP601: I2C Addr; SolderJumper-3_P1.3mm_Bridged12_RoundedPad1.0x1.5mm_NumberL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
U601: HP203B; LCSC Part C138665

Connections:
/I2C1SCL: U601.5 (SCL); also elsewhere on the board
/I2C1SDA: U601.6 (SDA); also elsewhere on the board
/VCC: C601.1, JP601.3 (B), U601.3 (VDD); also elsewhere on the board
GND: C601.2, JP601.1 (A), U601.2 (GND); also elsewhere on the board
unnamed: JP601.2 (C), U601.8 (CSB)

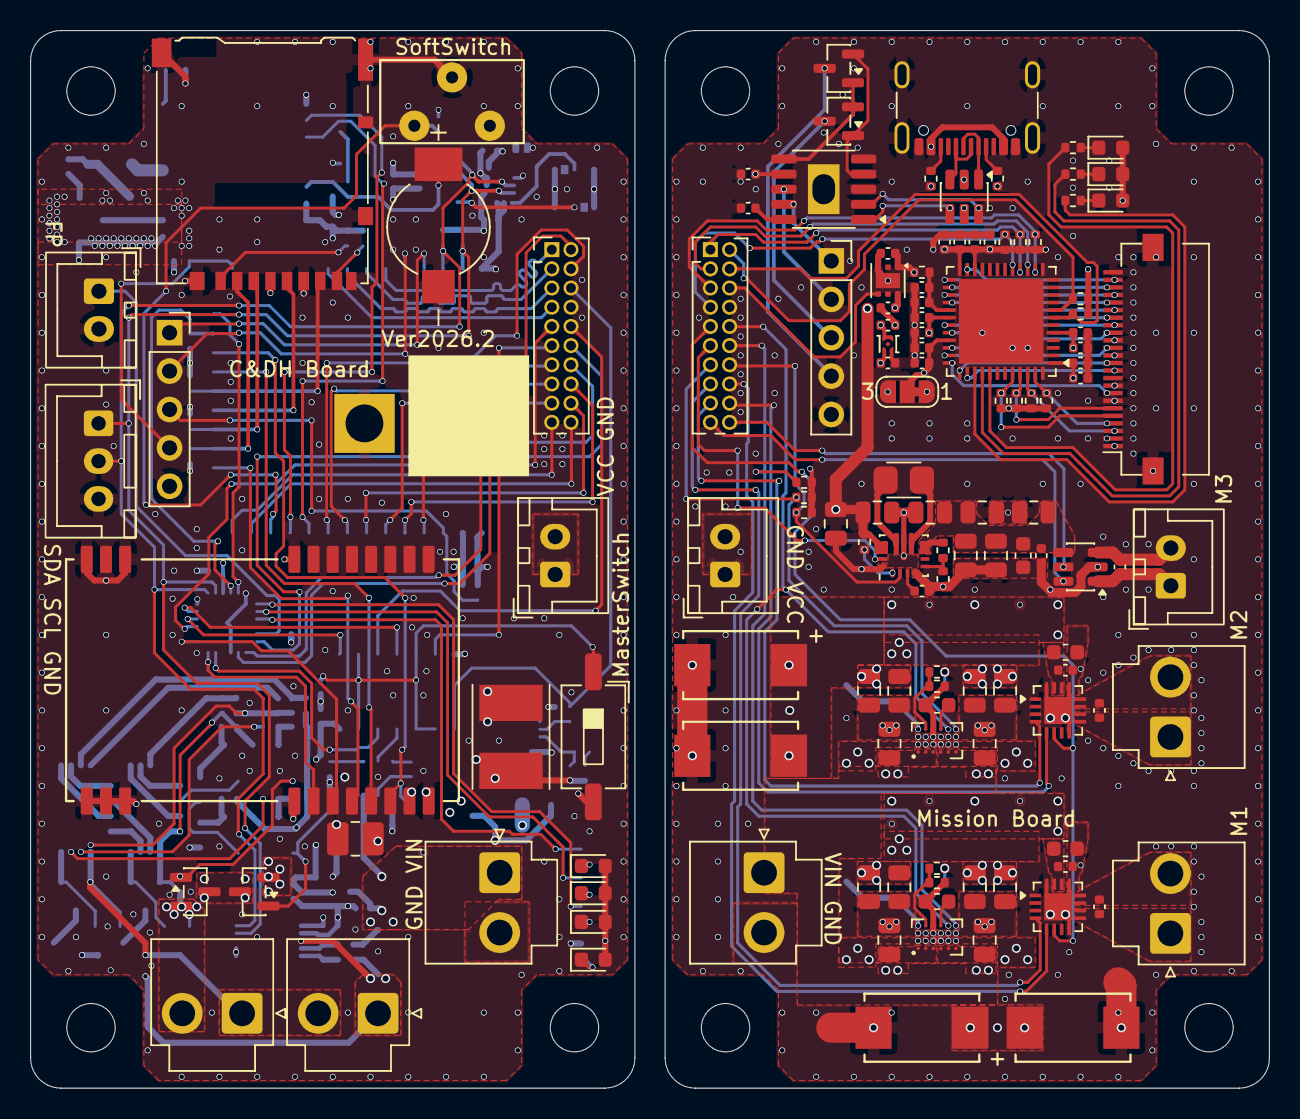
[picture p11: board cansat2026.kicad_pcb from above]

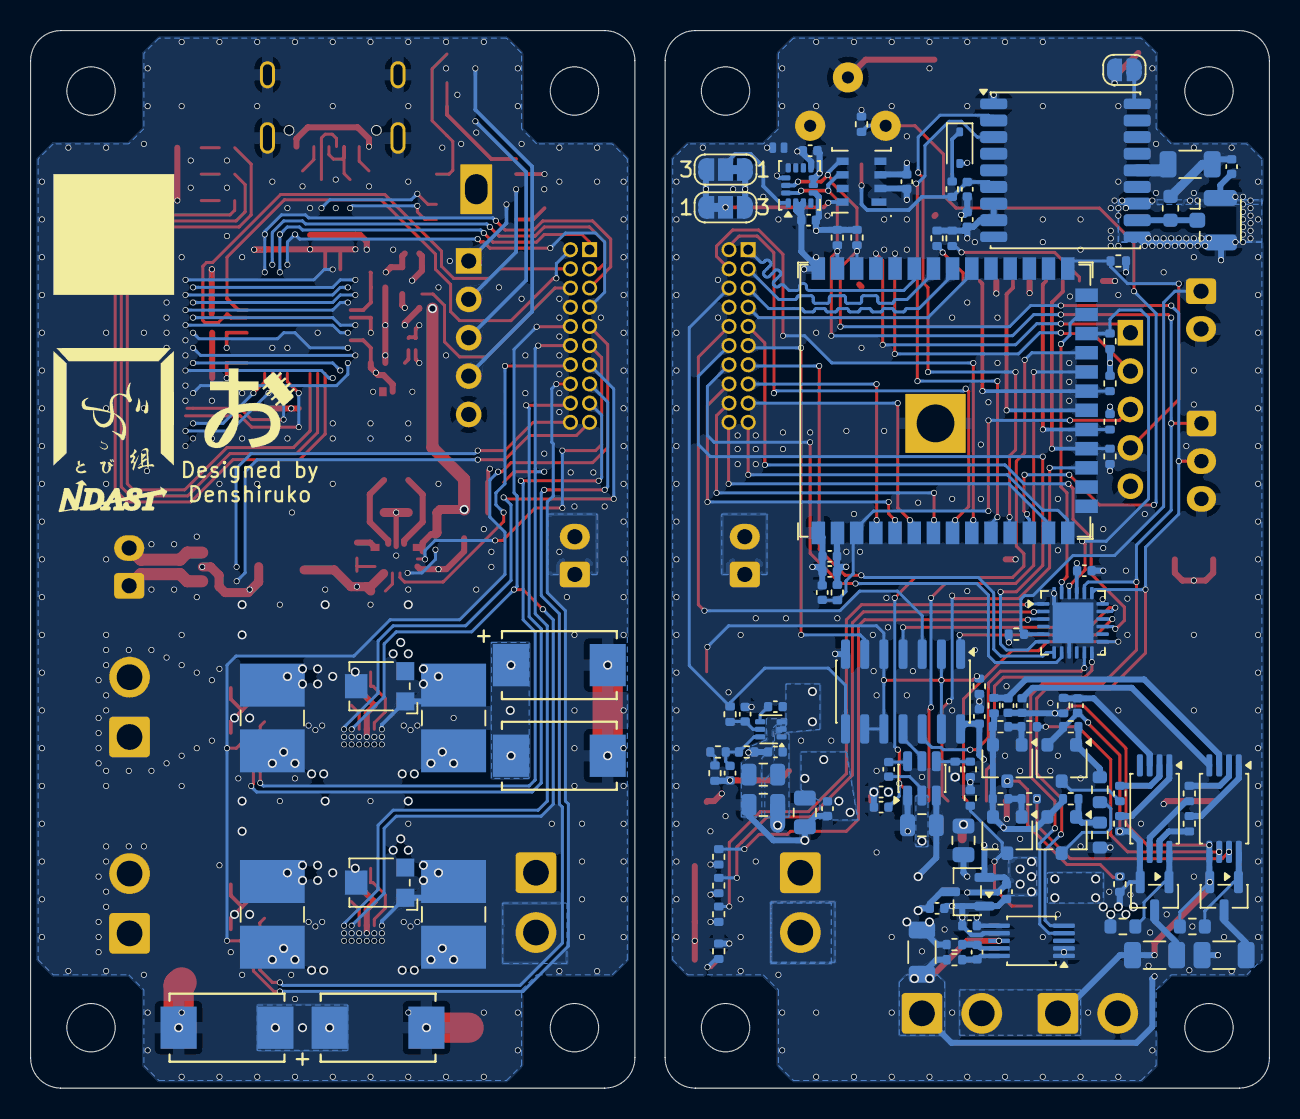
[picture p12: board cansat2026.kicad_pcb from below]

Board: 4 copper layers, 82.0 x 70.0 mm, 237 parts (113 on the bottom side), 164 nets.

Other parts of the board:
J101#2: MCU_UART_Conn; PinSocket_1x05_P2.54mm_Vertical

Their connections:
/EN: J101#2.3; also elsewhere on the board
/GPIO0: J101#2.4; also elsewhere on the board
/U0RXD: J101#2.2; also elsewhere on the board
/U0TXD: J101#2.1; also elsewhere on the board
GND: J101#2.5; also elsewhere on the board
