denshiruko/cansat2026-board/MCU/MCU.kicad_pcb

## KiCad design MCU/MCU.kicad_pcb (2026-04-03)

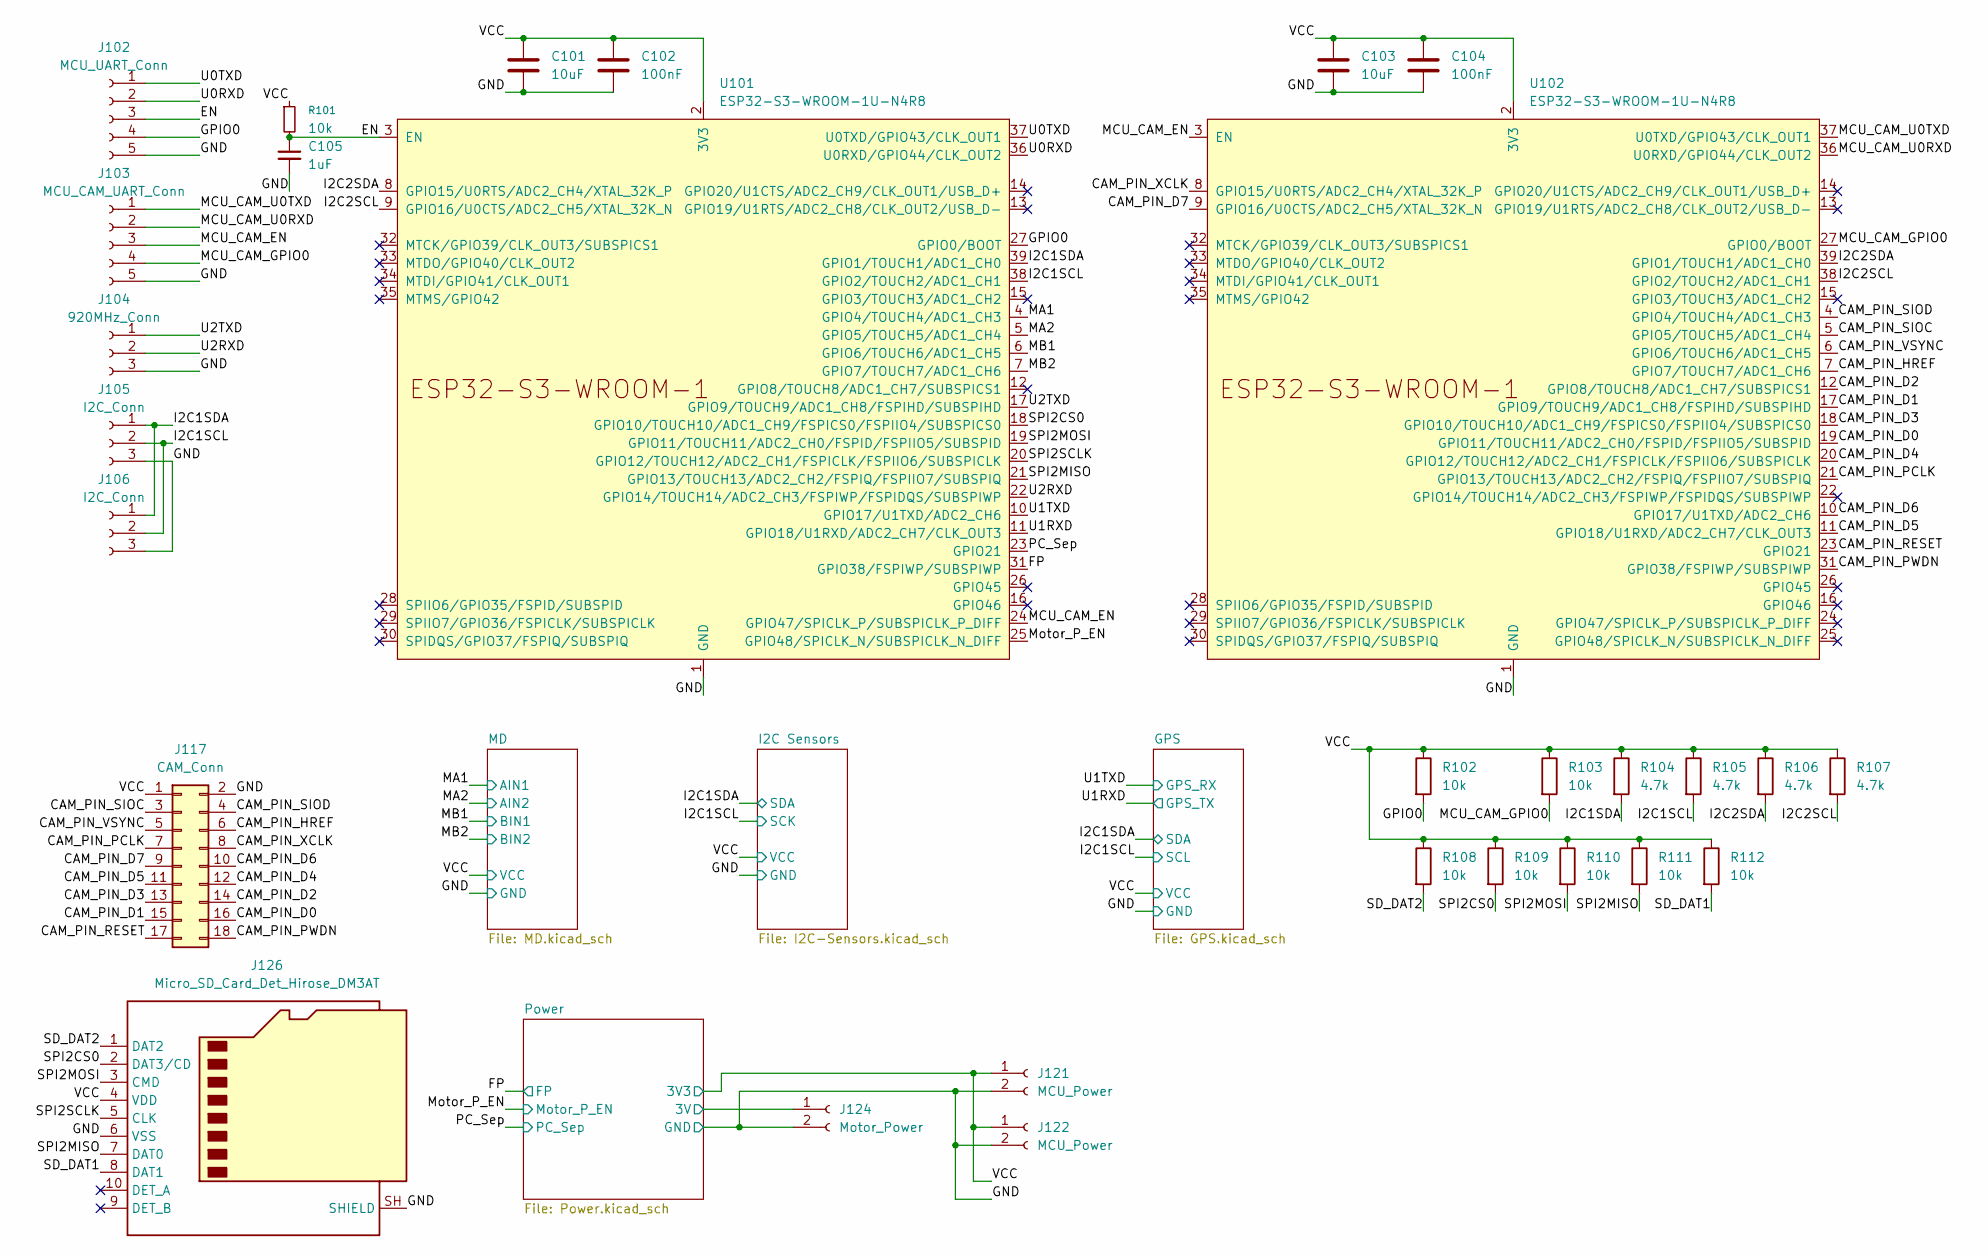
[picture p13: schematic MCU.kicad_sch]

Parts:
C101, C103: 10uF; C_0402_1005Metric; LCSC Part C15525
C102, C104: 100nF; C_0402_1005Metric; LCSC Part C1525
C105: 1uF; C_0402_1005Metric; LCSC Part C52923
J102: MCU_UART_Conn; PinSocket_1x05_P2.54mm_Vertical
J103: MCU_CAM_UART_Conn; PinSocket_1x05_P2.54mm_Vertical
J104: 920MHz_Conn; JST_XH_B3B-XH-A_1x03_P2.50mm_Vertical
J105, J106: I2C_Conn; JST_XH_B3B-XH-A_1x03_P2.50mm_Vertical
J117: CAM_Conn; PinHeader_2x10_P2.54mm_Vertical
J121, J122: MCU_Power; JST_XH_B2B-XH-A_1x02_P2.50mm_Vertical
J124: Motor_Power; JST_XH_B2B-XH-A_1x02_P2.50mm_Vertical
J126: Micro_SD_Card_Det_Hirose_DM3AT; microSD_HC_Hirose_DM3AT-SF-PEJM5
R101, R102, R103, R108, R109, R110, R111, R112: 10k; R_0402_1005Metric; LCSC Part C25744
R104, R105, R106, R107: 4.7k; R_0402_1005Metric; LCSC Part C25900
U101, U102: ESP32-S3-WROOM-1U-N4R8; ESP32-S3-WROOM-1U; Mouser Part 356-ESP32S3WRM1UN4R8; LCSC Part C3013943

Connections:
/CAM_PIN_D0: J117.16, U102.19 (GPIO11/TOUCH11/ADC2_CH0/FSPID/FSPIIO5/S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)
/CAM_PIN_D1: J117.15, U102.17 (GPIO9/TOUCH9/ADC1_CH8/FSPIHD/SUBSPIHD)
/CAM_PIN_D2: J117.14, U102.12 (GPIO8/TOUCH8/ADC1_CH7/SUBSPICS1)
/CAM_PIN_D3: J117.13, U102.18 (GPIO10/TOUCH10/ADC1_CH9/FSPICS0/FSPIIO4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)
/CAM_PIN_D4: J117.12, U102.20 (GPIO12/TOUCH12/ADC2_CH1/FSPICLK/FSPIIO6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)
/CAM_PIN_D5: J117.11, U102.11 (GPIO18/U1RXD/ADC2_CH7/CLK_OUT3)
/CAM_PIN_D6: J117.10, U102.10 (GPIO17/U1TXD/ADC2_CH6)
/CAM_PIN_D7: J117.9, U102.9 (GPIO16/U0CTS/ADC2_CH5/XTAL_32K_N)
/CAM_PIN_HREF: J117.6, U102.7 (GPIO7/TOUCH7/ADC1_CH6)
/CAM_PIN_PCLK: J117.7, U102.21 (GPIO13/TOUCH13/ADC2_CH2/FSPIQ/FSPIIO7/S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)
/CAM_PIN_PWDN: J117.18, U102.31 (GPIO38/FSPIWP/SUBSPIWP)
/CAM_PIN_RESET: J117.17, U102.23 (GPIO21)
/CAM_PIN_SIOC: J117.3, U102.5 (GPIO5/TOUCH5/ADC1_CH4)
/CAM_PIN_SIOD: J117.4, U102.4 (GPIO4/TOUCH4/ADC1_CH3)
/CAM_PIN_VSYNC: J117.5, U102.6 (GPIO6/TOUCH6/ADC1_CH5)
/CAM_PIN_XCLK: J117.8, U102.8 (GPIO15/U0RTS/ADC2_CH4/XTAL_32K_P)
/EN: C105.1, J102.3, R101.2, U101.3 (EN)
/FP: U101.31 (GPIO38/FSPIWP/SUBSPIWP); also elsewhere on the board
/GPIO0: J102.4, R102.2, U101.27 (GPIO0/BOOT)
/I2C1SCL: J105.2, J106.2, R105.2, U101.38 (GPIO2/TOUCH2/ADC1_CH1); also elsewhere on the board
/I2C1SDA: J105.1, J106.1, R104.2, U101.39 (GPIO1/TOUCH1/ADC1_CH0); also elsewhere on the board
/I2C2SCL: R107.2, U101.9 (GPIO16/U0CTS/ADC2_CH5/XTAL_32K_N), U102.38 (GPIO2/TOUCH2/ADC1_CH1)
/I2C2SDA: R106.2, U101.8 (GPIO15/U0RTS/ADC2_CH4/XTAL_32K_P), U102.39 (GPIO1/TOUCH1/ADC1_CH0)
/MA1: U101.4 (GPIO4/TOUCH4/ADC1_CH3); also elsewhere on the board
/MA2: U101.5 (GPIO5/TOUCH5/ADC1_CH4); also elsewhere on the board
/MB1: U101.6 (GPIO6/TOUCH6/ADC1_CH5); also elsewhere on the board
/MB2: U101.7 (GPIO7/TOUCH7/ADC1_CH6); also elsewhere on the board
/MCU_CAM_EN: J103.3, U101.24 (GPIO47/SPICLK_P/SUBSPICLK_P_DIFF), U102.3 (EN)
/MCU_CAM_GPIO0: J103.4, R103.2, U102.27 (GPIO0/BOOT)
/MCU_CAM_U0RXD: J103.2, U102.36 (U0RXD/GPIO44/CLK_OUT2)
/MCU_CAM_U0TXD: J103.1, U102.37 (U0TXD/GPIO43/CLK_OUT1)
/Motor_P_EN: U101.25 (GPIO48/SPICLK_N/SUBSPICLK_N_DIFF); also elsewhere on the board
/PC_Sep: U101.23 (GPIO21); also elsewhere on the board
/Power/3V: J124.1; also elsewhere on the board
/SD_DAT1: J126.8 (DAT1), R112.2
/SD_DAT2: J126.1 (DAT2), R108.2
/SPI2CS0: J126.2 (DAT3/CD), R109.2, U101.18 (GPIO10/TOUCH10/ADC1_CH9/FSPICS0/FSPIIO4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)
/SPI2MISO: J126.7 (DAT0), R111.2, U101.21 (GPIO13/TOUCH13/ADC2_CH2/FSPIQ/FSPIIO7/S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)
/SPI2MOSI: J126.3 (CMD), R110.2, U101.19 (GPIO11/TOUCH11/ADC2_CH0/FSPID/FSPIIO5/S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)
/SPI2SCLK: J126.5 (CLK), U101.20 (GPIO12/TOUCH12/ADC2_CH1/FSPICLK/FSPIIO6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)
/U0RXD: J102.2, U101.36 (U0RXD/GPIO44/CLK_OUT2)
/U0TXD: J102.1, U101.37 (U0TXD/GPIO43/CLK_OUT1)
/U1RXD: U101.11 (GPIO18/U1RXD/ADC2_CH7/CLK_OUT3); also elsewhere on the board
/U1TXD: U101.10 (GPIO17/U1TXD/ADC2_CH6); also elsewhere on the board
/U2RXD: J104.2, U101.22 (GPIO14/TOUCH14/ADC2_CH3/FSPIWP/FSPIDQS/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)
/U2TXD: J104.1, U101.17 (GPIO9/TOUCH9/ADC1_CH8/FSPIHD/SUBSPIHD)
/VCC: C101.1, C102.1, C103.1, C104.1, J117.1, J121.1, J122.1, J126.4 (VDD), R101.1, R102.1, R103.1, R104.1, R105.1, R106.1, R107.1, R108.1, R109.1, R110.1, R111.1, R112.1, U101.2 (3V3), U102.2 (3V3); also elsewhere on the board
GND: C101.2, C102.2, C103.2, C104.2, C105.2, J102.5, J103.5, J104.3, J105.3, J106.3, J117.2, J121.2, J122.2, J124.2, J126.6 (VSS), J126.SH (SHIELD), U101.1 (GND), U101.40 (GND), U101.41 (GND), U102.1 (GND), U102.40 (GND), U102.41 (GND); also elsewhere on the board

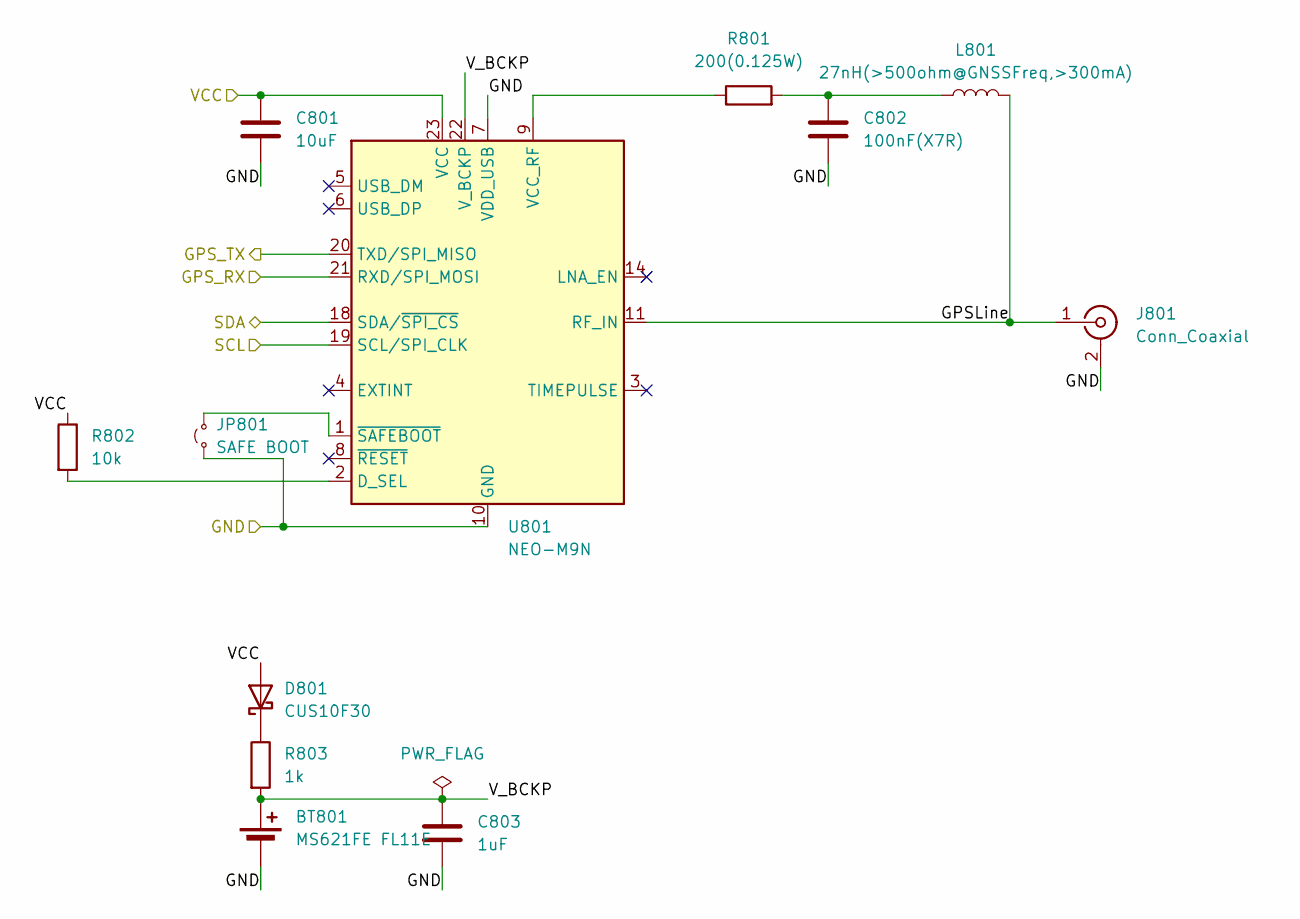
[picture p14: schematic GPS.kicad_sch]

Parts:
BT801: MS621FE FL11E; BatteryHolder_Seiko_MS621F
C801: 10uF; C_0402_1005Metric; LCSC Part C15525
C802: 100nF(X7R); C_0402_1005Metric; LCSC Part C1525
C803: 1uF; C_0402_1005Metric; LCSC Part C52923
D801: CUS10F30; D_SOD-323
J801: Conn_Coaxial; SMA_Amphenol_132134-11_Vertical
JP801: SAFE BOOT; SolderJumper-2_P1.3mm_Open_RoundedPad1.0x1.5mm
L801: 27nH(>500ohm@GNSSFreq,>300mA); L_0603_1608Metric; Mouser Part 710-7447860127G
R801: 200(0.125W); R_0805_2012Metric; LCSC Part C17540
R802: 10k; R_0402_1005Metric; LCSC Part C25744
R803: 1k; R_0402_1005Metric; LCSC Part C11702
U801: NEO-M9N; ublox_NEO; Mouser Part 377-NEO-M9N-00B

Connections:
/GPS/GPSLine: J801.1 (In), L801.2, U801.11 (RF_IN)
/GPS/V_BCKP: BT801.1 (+), C803.1, R803.2, U801.22 (V_BCKP)
/I2C1SCL: U801.19 (SCL/SPI_CLK); also elsewhere on the board
/I2C1SDA: U801.18 (SDA/~SPI_CS); also elsewhere on the board
/U1RXD: U801.20 (TXD/SPI_MISO); also elsewhere on the board
/U1TXD: U801.21 (RXD/SPI_MOSI); also elsewhere on the board
/VCC: C801.1, D801.2 (A), R802.1, U801.23 (VCC); also elsewhere on the board
GND: BT801.2 (-), C801.2, C802.2, C803.2, J801.2 (Ext), JP801.1 (A), U801.7 (VDD_USB), U801.10 (GND), U801.12 (GND), U801.13 (GND), U801.24 (GND); also elsewhere on the board
unnamed: C802.1, L801.1, R801.2
unnamed: D801.1 (K), R803.1
unnamed: JP801.2 (B), U801.1 (~SAFEBOOT)
unnamed: R802.2, U801.2 (D_SEL)
unnamed: R801.1, U801.9 (VCC_RF)

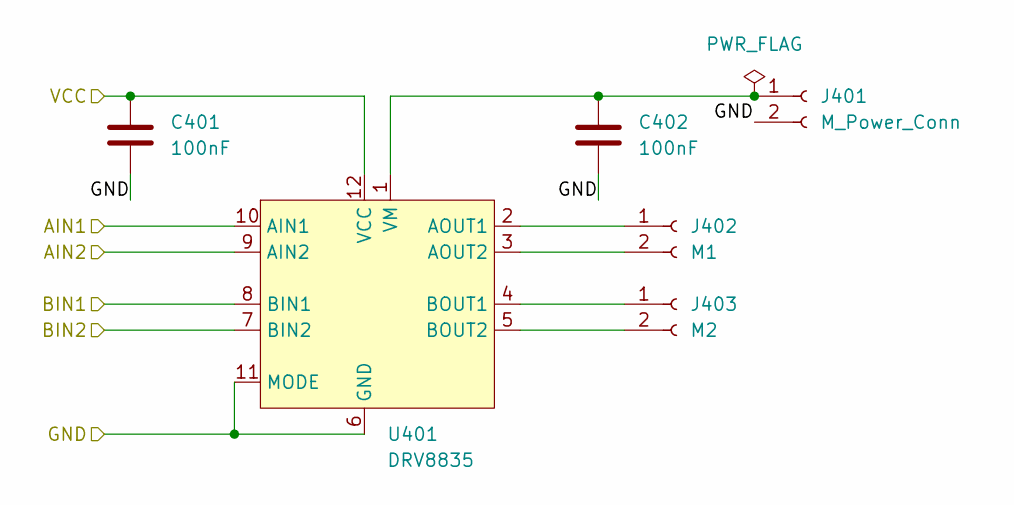
[picture p15: schematic MD.kicad_sch]

Parts:
C401, C402: 100nF; C_0402_1005Metric; LCSC Part C1525
J401: M_Power_Conn; JST_XH_B2B-XH-A_1x02_P2.50mm_Vertical
J402: M1; JST_XH_B2B-XH-A_1x02_P2.50mm_Vertical
J403: M2; JST_XH_B2B-XH-A_1x02_P2.50mm_Vertical
U401: DRV8835; WSON-12-1EP_3x2mm_P0.5mm_EP1x2.65_ThermalVias; LCSC Part C129328

Connections:
/MA1: U401.10 (AIN1); also elsewhere on the board
/MA2: U401.9 (AIN2); also elsewhere on the board
/MB1: U401.8 (BIN1); also elsewhere on the board
/MB2: U401.7 (BIN2); also elsewhere on the board
/VCC: C401.1, U401.12 (VCC); also elsewhere on the board
GND: C401.2, C402.2, J401.2, U401.6 (GND), U401.11 (MODE), U401.13; also elsewhere on the board
unnamed: C402.1, J401.1, U401.1 (VM)
unnamed: J402.1, U401.2 (AOUT1)
unnamed: J402.2, U401.3 (AOUT2)
unnamed: J403.1, U401.4 (BOUT1)
unnamed: J403.2, U401.5 (BOUT2)

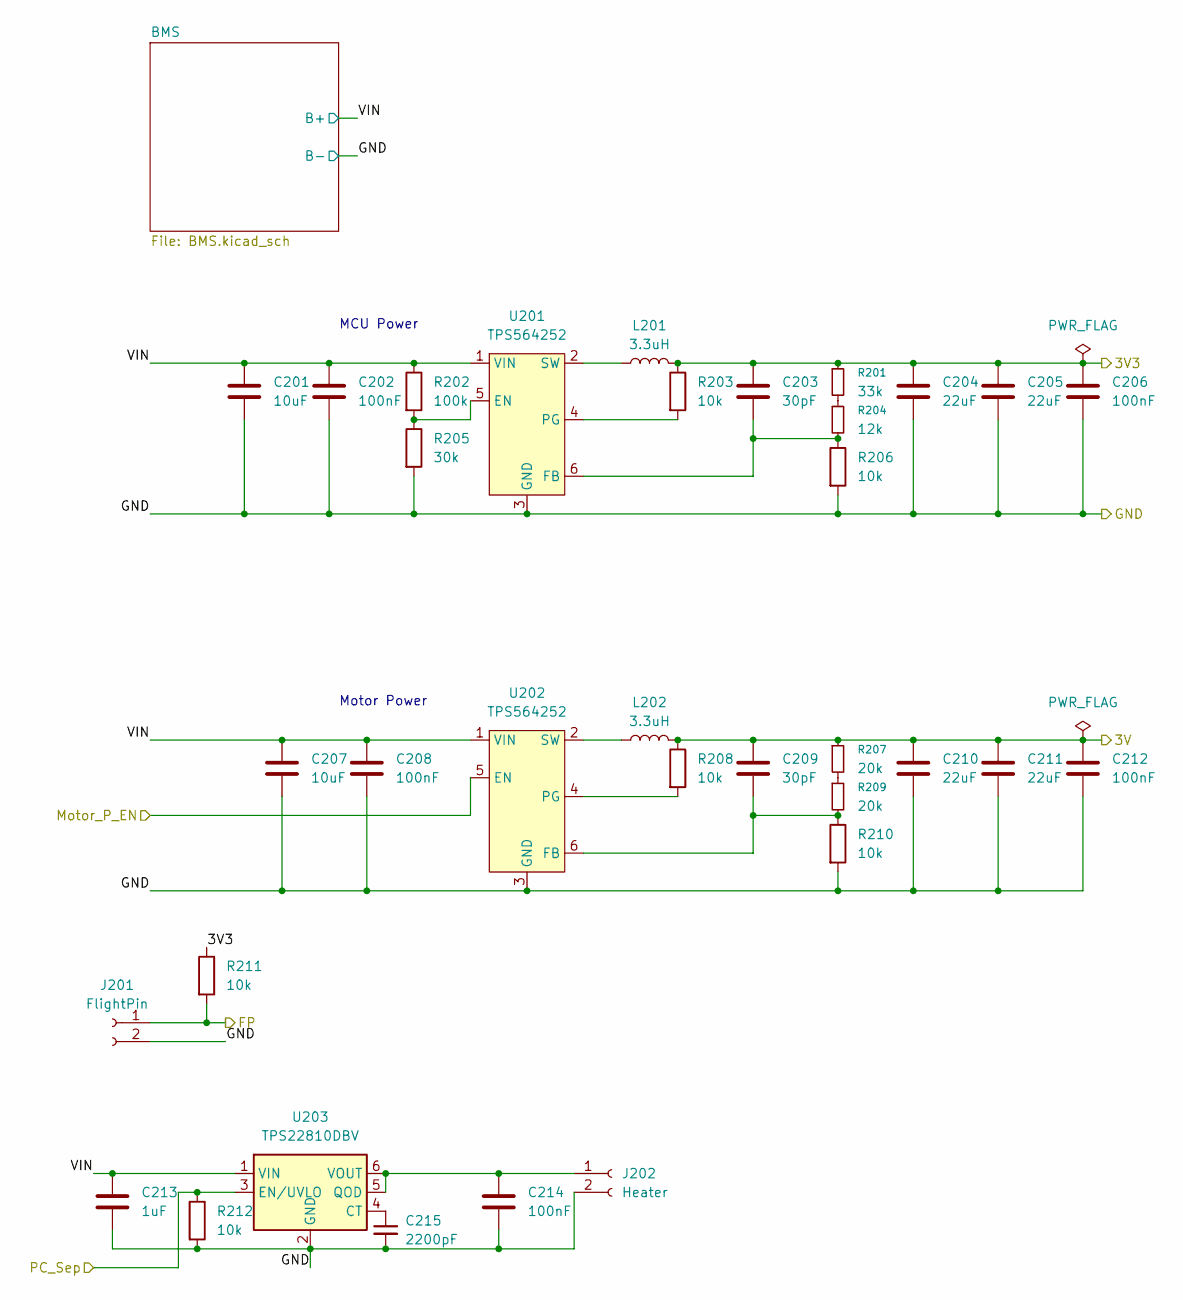
[picture p16: schematic Power.kicad_sch]

Parts:
C201, C207: 10uF; C_0805_2012Metric; LCSC Part C15850
C202, C208, C214: 100nF; C_0603_1608Metric; LCSC Part C14663
C203, C209: 30pF; C_0402_1005Metric; LCSC Part C1570
C204, C205, C210, C211: 22uF; C_0805_2012Metric; LCSC Part C45783
C206, C212: 100nF; C_0402_1005Metric; LCSC Part C1525
C213: 1uF; C_0402_1005Metric; LCSC Part C52923
C215: 2200pF; C_0402_1005Metric; LCSC Part C1531
J201: FlightPin; JST_XH_B2B-XH-A_1x02_P2.50mm_Vertical
J202: Heater; TerminalBlock_Phoenix_MKDS-1,5-2-5.08_1x02_P5.08mm_Horizont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
L201, L202: 3.3uH; L_TDK_VLS6045EX_VLS6045AF; Mouser Part 810-VLS6045EX-3R3N
R201: 33k; R_0402_1005Metric; LCSC Part C25779
R202: 100k; R_0402_1005Metric; LCSC Part C25741
R203, R206, R208, R210, R211, R212: 10k; R_0402_1005Metric; LCSC Part C25744
R204: 12k; R_0402_1005Metric; LCSC Part C25752
R205: 30k; R_0603_1608Metric; LCSC Part C22984
R207, R209: 20k; R_0402_1005Metric; LCSC Part C25765
U201, U202: TPS564252; SOT-563; Mouser Part 595-TPS564252DRLR; LCSC Part C19191267
U203: TPS22810DBV; SOT-23-6; Mouser Part 595-TPS22810DBVR; LCSC Part C2680364

Connections:
/FP: J201.1, R211.2; also elsewhere on the board
/Motor_P_EN: U202.5 (EN); also elsewhere on the board
/PC_Sep: R212.1, U203.3 (EN/UVLO); also elsewhere on the board
/Power/3V: C209.1, C210.1, C211.1, C212.1, L202.2, R207.1, R208.1; also elsewhere on the board
/Power/VIN: C201.1, C202.1, C207.1, C208.1, C213.1, R202.1, U201.1 (VIN), U202.1 (VIN), U203.1 (VIN); also elsewhere on the board
/VCC: C203.1, C204.1, C205.1, C206.1, L201.2, R201.1, R203.1, R211.1; also elsewhere on the board
GND: C201.2, C202.2, C204.2, C205.2, C206.2, C207.2, C208.2, C210.2, C211.2, C212.2, C213.2, C214.2, C215.2, J201.2, J202.2, R205.2, R206.2, R210.2, R212.2, U201.3 (GND), U202.3 (GND), U203.2 (GND); also elsewhere on the board
unnamed: C214.1, J202.1, U203.5 (QOD), U203.6 (VOUT)
unnamed: R201.2, R204.1
unnamed: R207.2, R209.1
unnamed: R202.2, R205.1, U201.5 (EN)
unnamed: C203.2, R204.2, R206.1, U201.6 (FB)
unnamed: R203.2, U201.4 (PG)
unnamed: L201.1, U201.2 (SW)
unnamed: C209.2, R209.2, R210.1, U202.6 (FB)
unnamed: R208.2, U202.4 (PG)
unnamed: L202.1, U202.2 (SW)
unnamed: C215.1, U203.4 (CT)

Notes on the sheet:
MCU Power
Motor Power
