denshiruko/cansat2026-board/MCU/MCU.kicad_pcb

## KiCad design MCU/MCU.kicad_pcb (continued)


Parts:
C301, C303: 100nF; C_0603_1608Metric; LCSC Part C14663
C302: 10nF; C_0402_1005Metric; LCSC Part C15195
J301, J302: Battery; JST_XH_B2B-XH-A_1x02_P2.50mm_Vertical
Q301, Q302, Q304: 2SB1198K; SC-59; Mouser Part 755-2SB1198KT146R; LCSC Part C266246
Q303, Q305: 2N7002; SOT-23; LCSC Part C8545
Q306: 2SC2412K; SC-59; Mouser Part 755-2SC2412KT146R; LCSC Part C111699
Q307, Q308: PJA3404A; SOT-23; Mouser Part 241-PJA3404AR100001
R301, R302, R310, R315, R316, R320: 1M; R_0402_1005Metric; LCSC Part C26083
R303, R304: 510k; R_0402_1005Metric; LCSC Part C11616
R305, R311: 470; R_0402_1005Metric; LCSC Part C25117
R306, R312: 51(1W); R_1206_3216Metric; Mouser Part 660-SG73S2BTTD51R0F
R307, R314: 10M; R_0402_1005Metric; LCSC Part C26082
R308, R309, R318, R319: 1k; R_0402_1005Metric; LCSC Part C11702
R313, R317: 4.7M; R_0603_1608Metric; LCSC Part C23163
U301, U302: S-8209ABB-T8T1U; TSSOP-8_4.4x3mm_P0.65mm; Mouser Part 628-S-8209ABB-T8T1U

Connections:
/Power/VIN: J301.1, Q301.2, Q302.2, Q304.2, R301.1, R302.1, R305.2, R306.2, R310.2; also elsewhere on the board
GND: Q307.2 (S), R313.1, R315.2; also elsewhere on the board
unnamed: C301.2, C302.2, J301.2, J302.1, Q303.2 (S), R307.2, R311.2, R312.2, U301.5 (VSS)
unnamed: C303.2, J302.2, Q305.2 (S), Q306.2, Q308.2 (S), R314.2, R316.1, R319.2, R320.2, U302.5 (VSS)
unnamed: Q301.1, R301.2, R303.1
unnamed: Q302.1, R302.2, R304.1
unnamed: Q303.3 (D), R306.1
unnamed: Q303.1 (G), R307.1, U301.8 (CB)
unnamed: Q304.1, R310.1, R313.2
unnamed: Q304.3, R317.2
unnamed: Q305.3 (D), R312.1
unnamed: Q305.1 (G), R314.1, U302.8 (CB)
unnamed: Q306.1, R317.1, R320.1
unnamed: Q306.3, R318.1
unnamed: Q307.3 (D), Q308.3 (D)
unnamed: Q301.3, Q307.1 (G), R315.1
unnamed: Q302.3, Q308.1 (G), R316.2
unnamed: C302.1, U301.4 (CDT)
unnamed: R303.2, U301.7 (CO)
unnamed: R309.1, U301.1 (CTLC)
unnamed: R308.1, U301.2 (CTLD)
unnamed: R304.2, U301.6 (DO)
unnamed: C301.1, R305.1, U301.3 (VDD)
unnamed: R309.2, U302.7 (CO)
unnamed: R319.1, U302.1 (CTLC)
unnamed: R318.2, U302.2 (CTLD)
unnamed: R308.2, U302.6 (DO)
unnamed: C303.1, R311.1, U302.3 (VDD)

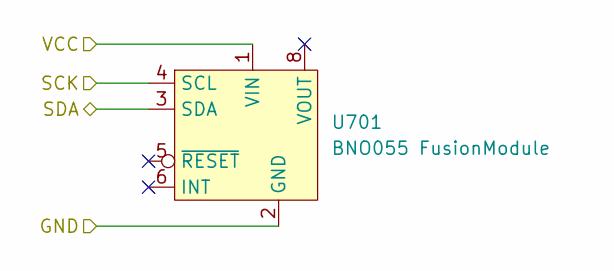
[picture p17: schematic IMU.kicad_sch]

Parts:
U701: BNO055 FusionModule; BNO055-FusionModule

Connections:
/I2C1SCL: U701.4 (SCL); also elsewhere on the board
/I2C1SDA: U701.3 (SDA); also elsewhere on the board
/VCC: U701.1 (VIN); also elsewhere on the board
GND: U701.2 (GND), U701.7 (GND); also elsewhere on the board

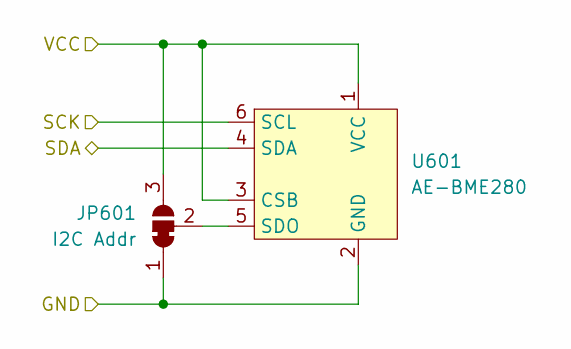
[picture p18: schematic PressureSensor.kicad_sch]

Parts:
JP601: I2C Addr; SolderJumper-3_P1.3mm_Bridged12_RoundedPad1.0x1.5mm_NumberL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
U601: AE-BME280

Connections:
/I2C1SCL: U601.6 (SCL); also elsewhere on the board
/I2C1SDA: U601.4 (SDA); also elsewhere on the board
/VCC: JP601.3 (B), U601.1 (VCC), U601.3 (CSB); also elsewhere on the board
GND: JP601.1 (A), U601.2 (GND); also elsewhere on the board
unnamed: JP601.2 (C), U601.5 (SDO)

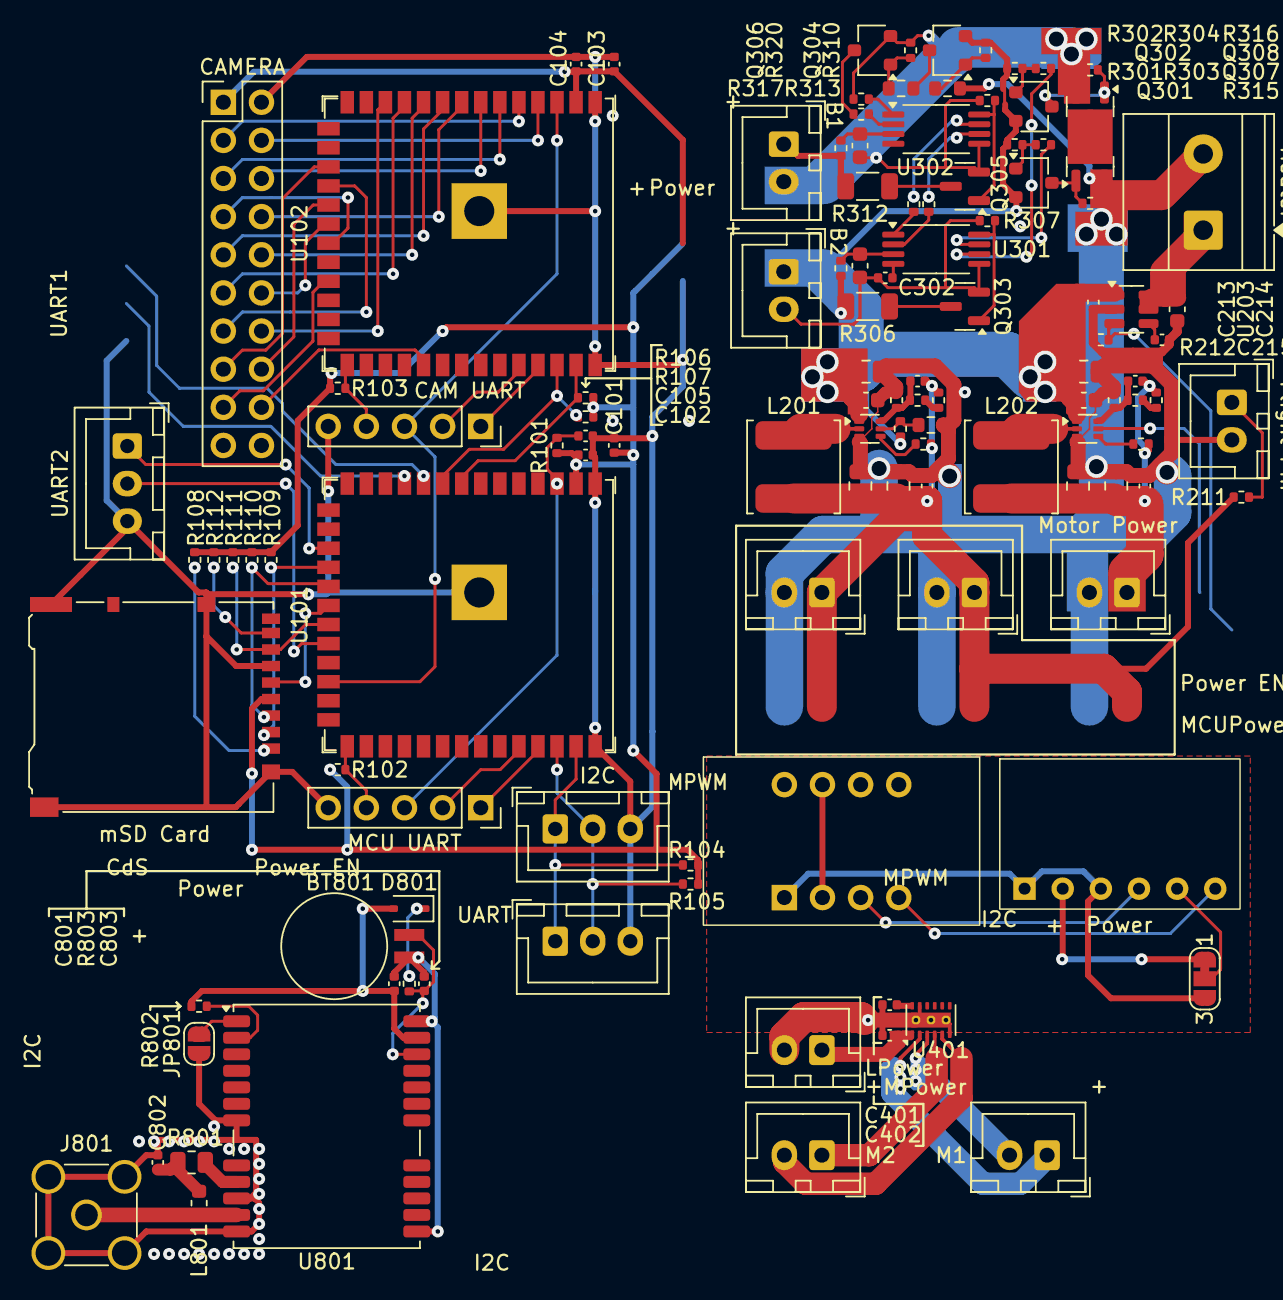
[picture p19: board MCU.kicad_pcb from above]

Board: 2 copper layers, 119 parts (0 on the bottom side), 99 nets.
