denshiruko/cansat2026-board/(commit log)

2026-04-03 Import: from cansat2025-board
    cansat2025-boardのv1.0からそのままコピーしてきた。
    これから修正とかしていく
    [BMS.kicad_sch, GPS.kicad_sch, I2C-Sensors.kicad_sch, IMU.kicad_sch, MCU.kicad_pcb, MCU.kicad_sch, MD.kicad_sch, Power.kicad_sch]
2026-04-03 Version Update: 9.0->10.0
    [BMS.kicad_sch, GPS.kicad_sch, I2C-Sensors.kicad_sch, IMU.kicad_sch, MCU.kicad_pcb, MCU.kicad_sch, MD.kicad_sch, Power.kicad_sch]
2026-04-03 Update: コネクタをだいぶ消した
    手配線になるね
    [BMS.kicad_sch, GPS.kicad_sch, I2C-Sensors.kicad_sch, MCU.kicad_sch, Power.kicad_sch, PressureSensor.kicad_sch]
2026-04-03 Update: 隙間を詰めてみた
    でも大きいなあ
    裏面が結構空いてる
    [MCU.kicad_pcb]
2026-04-03 Rename: MCU/ -> cansat2026/
    [BMS.kicad_sch, GPS.kicad_sch, I2C-Sensors.kicad_sch, IMU.kicad_sch, MD.kicad_sch, Power.kicad_sch, PressureSensor.kicad_sch, cansat2026.kicad_pcb]
2026-04-03 Update: MCUシートを作成
    MCU部分を分けた
    あとでFPGAつけるかもしれないしね
    [BMS.kicad_sch, GPS.kicad_sch, I2C-Sensors.kicad_sch, IMU.kicad_sch, MCU.kicad_sch, MD.kicad_sch, Power.kicad_sch, PressureSensor.kicad_sch]
2026-04-03 Update: ラベルをワイヤーにした
    ラベルが衝突してERCが出たから
    [MCU.kicad_sch, cansat2026.kicad_pcb, cansat2026.kicad_sch]
2026-04-23 Update: いろいろした
    無線変えた
    カメラのコネクタ変えた
    i2cセンサ変えた
    電源変えた:1.2V,3.8V,3.3V
    IOエキスパンダ追加
    FPGA追加
    [BMS.kicad_sch, FPGA.kicad_sch, GPS.kicad_sch, IMU.kicad_sch, MCU.kicad_sch, MD.kicad_sch, Power.kicad_sch, PressureSensor.kicad_sch]
2026-04-27 Update: MDと電源とか
    MD変えた
    モーター電源と主電源
    [BMS.kicad_sch, MCU.kicad_sch, MD.kicad_sch, Power.kicad_sch, cansat2026.kicad_sch]
2026-04-28 Update: いろいろした
    GPS変えた
    USB追加した
    気圧センサ変えた
    FPGA変えた
    MDにキャパシタ追加した
    [FPGA.kicad_sch, GPS.kicad_sch, MCU.kicad_sch, MD.kicad_sch, Power.kicad_sch, PressureSensor.kicad_sch, USB.kicad_sch, cansat2026.kicad_sch]
2026-06-28 Update: 完成した
    [BMS.kicad_sch, FPGA.kicad_sch, GPS.kicad_sch, IMU.kicad_sch, MCU.kicad_sch, MD.kicad_sch, Power.kicad_sch, USB.kicad_sch]
2026-09-29 ARLISSに作り直した
    [BMS.kicad_sch, FPGA.kicad_sch, GPS.kicad_sch, IMU.kicad_sch, MCU.kicad_sch, MD.kicad_sch, Power.kicad_sch, USB.kicad_sch]
2026-10-26 カメラのSCCBのPUをDNPに
    [MCU.kicad_sch, cansat2026.kicad_pcb]
